ryanmio/EdmundFitzgeraldController/docs/images/forward-audio-component.jpeg

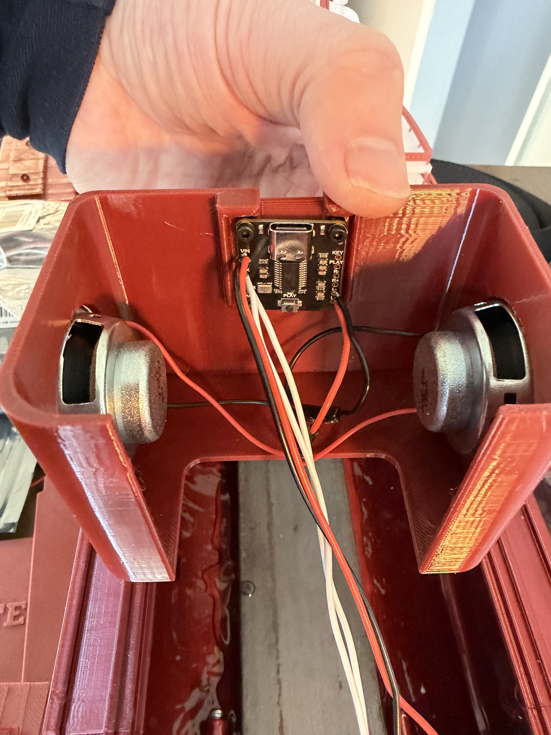
docs/images/forward-audio-component.jpeg
