ryanmio/EdmundFitzgeraldController/docs/UI_DESIGN_BRIEF.md

# UI Design Brief: 1970s Great Lakes Freighter Bridge Console

## Objective
Redesign the boat telemetry app UI to be **thematically authentic to a 1970s Great Lakes freighter bridge console**. The app should feel like you're controlling an actual Edmund Fitzgerald-era vessel.

## Visual Inspiration & Aesthetic

### Core Theme: Vintage Ship Bridge Console (circa 1970s)
- **Color Palette**: Deep teals, steel grays, muted oranges, black backgrounds with amber/green LED displays
- **Materials**: Brushed aluminum, steel, vintage gauge glass, weathered instrumentation
- **Lighting**: Low ambient lighting with bright instrument displays (like real bridge consoles)
- **Typography**: Industrial monospace fonts (like digital LED displays from that era)
- **Texture**: Slight grain/wear on surfaces, metal mesh backgrounds, subtle scanlines

### Reference Aesthetic
- 1970s maritime navigation equipment (radar scopes, depth finders, radio panels)
- Vintage control room instrumentation (physical buttons, rotary dials, analog gauges)
- Classic ship bridge layouts with clustered instrument banks
- Amber/green monochromatic displays (like old CRT monitors)
- Weathered but functional industrial design

---

## App Sections & Design Approach

### 1. **Connection Screen**
- Should feel like the "boot-up" screen of a 1970s naval computer
- Display: Amber monospace text on dark background
- Elements:
  - Ship silhouette or stylized Edmund Fitzgerald outline
  - IP address input styled like a vintage terminal/radio interface
  - Status lights (amber, red, green) for connection state
  - Connect button styled like a large industrial pushbutton
  - Easter egg: Startup sequence/boot animation

**Design Elements:**
- Flickering text effect (subtle, not annoying)
- Scandlines overlay (very light)
- Input field styled like a brass-trimmed control panel slot
- Status LEDs with glow effects

### 2. **Dashboard/Bridge Console (Main Screen)**
- Layout: Multi-panel bridge console feel
- Simulate a crew's-eye-view of instrumentation

#### Top Section: Header/Status Bar
- Ship name (USS Edmund Fitzgerald or similar styling)
- Current time (24-hour format, ship's time)
- Power button styled as vintage switch or emergency cutoff
- Signal strength displayed as classic dBm gauge or vertical bars (like old radio strength indicators)

#### Main Telemetry Panels (Arranged like real bridge stations)

**Panel 1: Power/Battery Station**
- Large analog gauge showing battery voltage (0-16V scale)
- Needle movement with subtle glow
- Readout text in amber monospace below
- Danger zone shading (red) at low voltages
- Background: Dark with grid pattern overlay

**Panel 2: Water Intrusion Detection**
- Large circular status display (like a depth gauge)
- "DRY" or "INTRUSION DETECTED" in bold amber text
- Alarm state: Red background with flashing border
- Subtle water wave animation when wet (optional)

**Panel 3: System Status/Uptime**
- Uptime in "HHMM:SS" format (ship chronometer style)
- Background: Black with subtle LED matrix pattern
- Font: Monospace, amber text
- Small annotations like "OPERATIONAL HOURS" above

**Panel 4: Signal Strength**
- Vertical bar graph (like old audio level meters)
- dBm reading in corner
- Color gradient: Green (good) → Yellow (fair) → Red (poor)
- Subtle needle animation

**Panel 5: LED Control Station**
- Two large toggle buttons styled like vintage control panel switches
  - "RUNNING MODE LED" - large industrial toggle
  - "FLOOD MODE LED" - large industrial toggle
- State indicators showing ON/OFF with glowing LED circles
- Styling: Brushed aluminum frame, recessed buttons, safety guards
- When active: Bright green LED glow, when off: dark gray
- Click/tactile feedback animation

#### Center/Lower Section: Optional Details
- System diagnostics readout (scrolling monospace text)
- Ambient shipboard sounds (very subtle - optional)
- "BRIDGE CONSOLE STATUS" panel with system health check

---

## Design Specifications

### Color Palette
```
Primary Colors:
- Background: #0a0e1a (Very dark blue-black)
- Text/Displays: #ffb000 (Amber/gold - classic LED color)
- Accent: #00c853 (Vintage green - active state)
- Alert: #ff3333 (Bright red - warning/alarm)
- Secondary: #4a5f7f (Steel gray for panels)

Gradients:
- Gauge backgrounds: Dark gray to black with slight metallic sheen
- Panel edges: Subtle beveled effect (raised or inset)
```

### Typography
- **Primary Font**: IBM Plex Mono, Courier Prime, or similar monospace
- **All text**: Uppercase or small-caps where appropriate (maritime style)
- **Sizes**: Large for critical info (battery, water status), smaller for labels

### Interactive Elements
- Buttons: Large, tactile, industrial pushbutton aesthetic
- Toggle switches: Classic up/down toggle style with physical appearance
- Gauges: Analog needle movement, glass reflection overlay
- Text displays: Dot-matrix or LED segment appearance

### Animation & Effects (Subtle, Authentic)
- Needle gauge movements: Smooth easing, slight overshoot (like real needles)
- Text flicker: Optional very subtle effect when connecting/updating
- LED glow: Bloom effect on active LEDs
- Scanlines: Ultra-light overlay (subtle, not distracting)
- Transitions: Fade or slide effects (avoiding 2020s smoothness)

---

## Layout Structure

### Spatial Arrangement (Bridge Console Pattern)
```
┌──────────────────────────────────────────────┐
│  [Ship Name]  [Time]  [Signal ▓▓▓▓░]  [⏻]   │  ← Header
├──────────────────────────────────────────────┤
│                                              │
│  [Battery Gauge]     [Water Status]         │  ← Row 1: Critical Systems
│   8.4V                 DRY                   │
│                                              │
├──────────────────────────────────────────────┤
│                                              │
│  [Uptime: 00:45:23]   [Signal: -53dBm]      │  ← Row 2: System Info
│                                              │
├────────────────────────────��─────────────────┤
│                                              │
│   ┌─ RUNNING MODE ─┐   ┌─ FLOOD MODE ─┐    │  ← Row 3: Control Switches
│   │  [LED: OFF]    │   │  [LED: OFF]   │    │
│   │  ◯ Toggle ON   │   │  ◯ Toggle ON  │    │
│   └────────────────┘   └───────────────┘    │
│                                              │
├──────────────────────────────────────────────┤
│ [DIAGNOSTIC STATUS]                         │
│ System Online | Console Active | GPS Sync   │  ← Footer (optional)
└──────────────────────────────────────────────┘
```

---

## Additional Features & Polish

### Accessibility & Usability
- High contrast for readability (amber on black meets WCAG standards)
- Large touch targets for buttons (for maritime/gloved hands)
- Simple iconography (if used)
- Status indicators always visible and unambiguous

### Optional Enhancements
- Subtle ambient shipboard sounds (low volume option)
- Small ship telemetry stats in corner ("CREW: 0 | CARGO: — | DRAFT: —")
- Fake "RADAR" or "SONAR" animations in background
- Ship log/event history panel (timestamp + event scrolling text)
- "MANUAL OVERRIDE" emergency button (styled for disconnect)

### Screen States

#### Normal Operation
- Steady amber glow, all systems reporting
- Calm, professional appearance

#### Alert State (Water Detected)
- Red background flash
- Alarm beep sound (optional)
- "⚠ WATER INTRUSION DETECTED" banner
- System continues operating but highlights danger

#### Disconnected State
- All displays dim/gray out
- Connection retry animation
- "SEARCHING FOR SIGNAL" text scrolling

---

## Design Deliverables

1. **Figma/Design File**: Full mockups of all screens and states
2. **Component Library**: Reusable UI components (gauge, button, panel, etc.)
3. **Color & Typography Guide**: Exact values for implementation
4. **Animation Specs**: Easing curves, timing for gauge movements, transitions
5. **Implementation Notes**: React Native code suggestions for achieving effects

---

## Tone & Philosophy

The UI should make the user feel like they're:
- Operating a real, historic Great Lakes freighter bridge
- Professional and capable, not just "using an app"
- Respectful of the ship's legacy and maritime heritage
- In control of something substantial and important

**Goal**: Every interaction should feel like stepping into a 1970s ship's bridge, even if just for a moment. The app is a tribute to the Edmund Fitzgerald and the era it represents.

---

## Next Steps for Designer

1. Start with the **Connection Screen** mockup (simplest)
2. Then design the **Dashboard/Main Console** layout
3. Create component variants (active/inactive states, alert states)
4. Build animation specs for gauges and LED indicators
5. Iterate with user feedback on authentic vs. modern balance
6. Finalize implementation strategy for React Native

---

**Brief prepared by**: Original Development Team  
**Date**: 2025-12-20  
**Target App**: Boat Telemetry - Edmund Fitzgerald Controller  
**Design Era**: 1970s Maritime Bridge Console Aesthetic
