ryanmio/EdmundFitzgeraldController/boat-telemetry-app/assets/boat.png

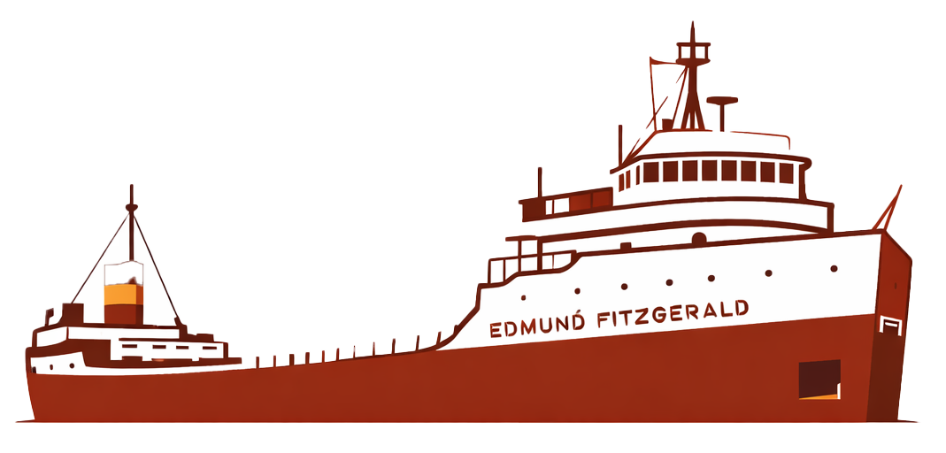
boat-telemetry-app/assets/boat.png
