ryanmio/EdmundFitzgeraldController/docs/images/cat-watching.jpeg

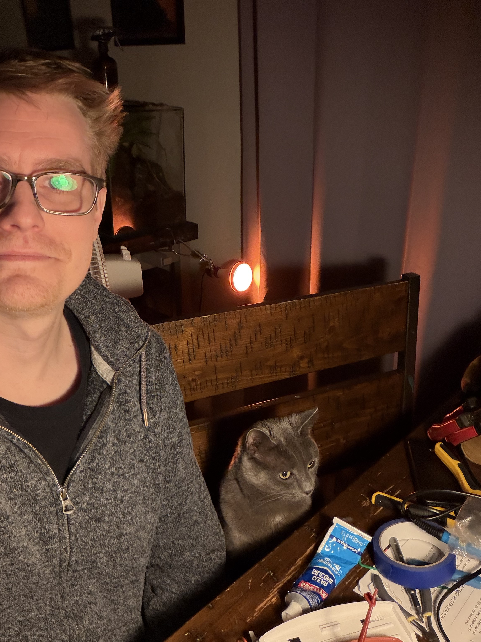
docs/images/cat-watching.jpeg
