ryanmio/EdmundFitzgeraldController/docs/images/interior-model.jpeg

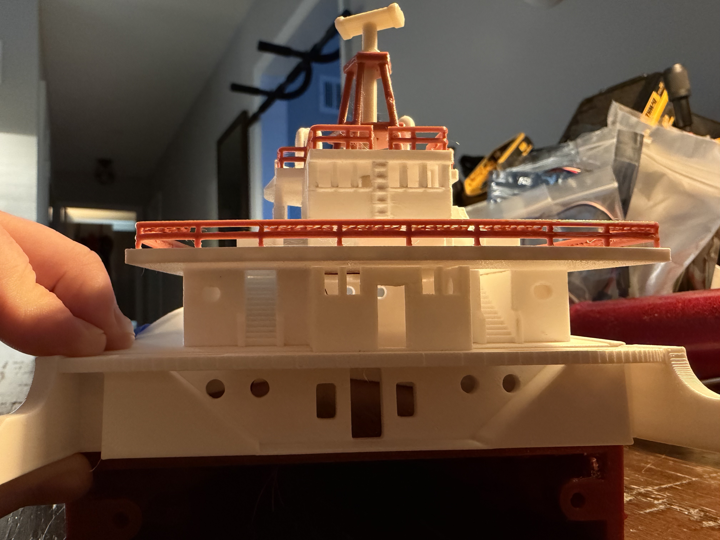
docs/images/interior-model.jpeg
