ryanmio/EdmundFitzgeraldController/docs/images/view-into-hull-from-above.jpeg

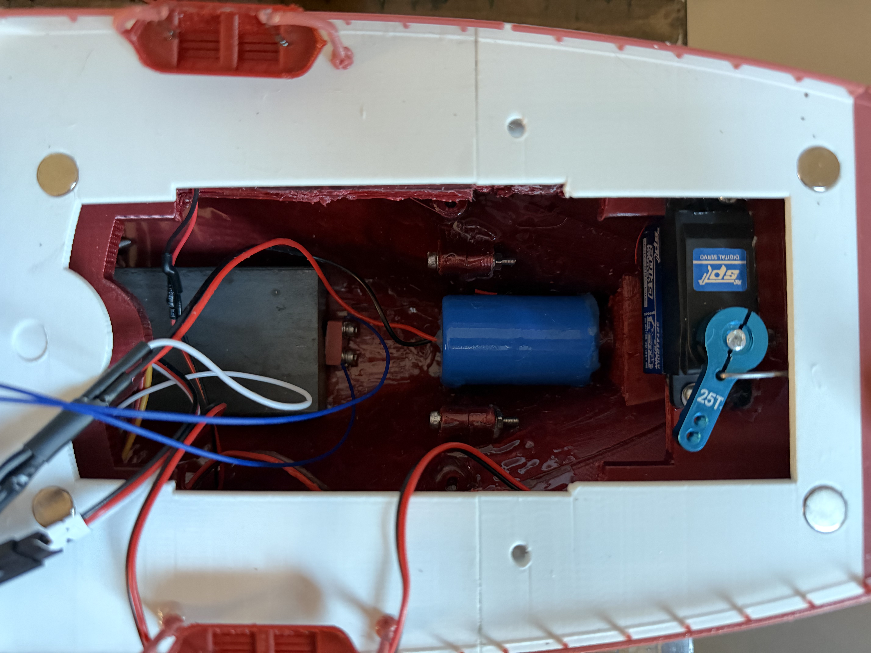
docs/images/view-into-hull-from-above.jpeg
