ryanmio/EdmundFitzgeraldController/docs/schematics/Edmund_Fitzgerald_Telemetry-backup.jpg

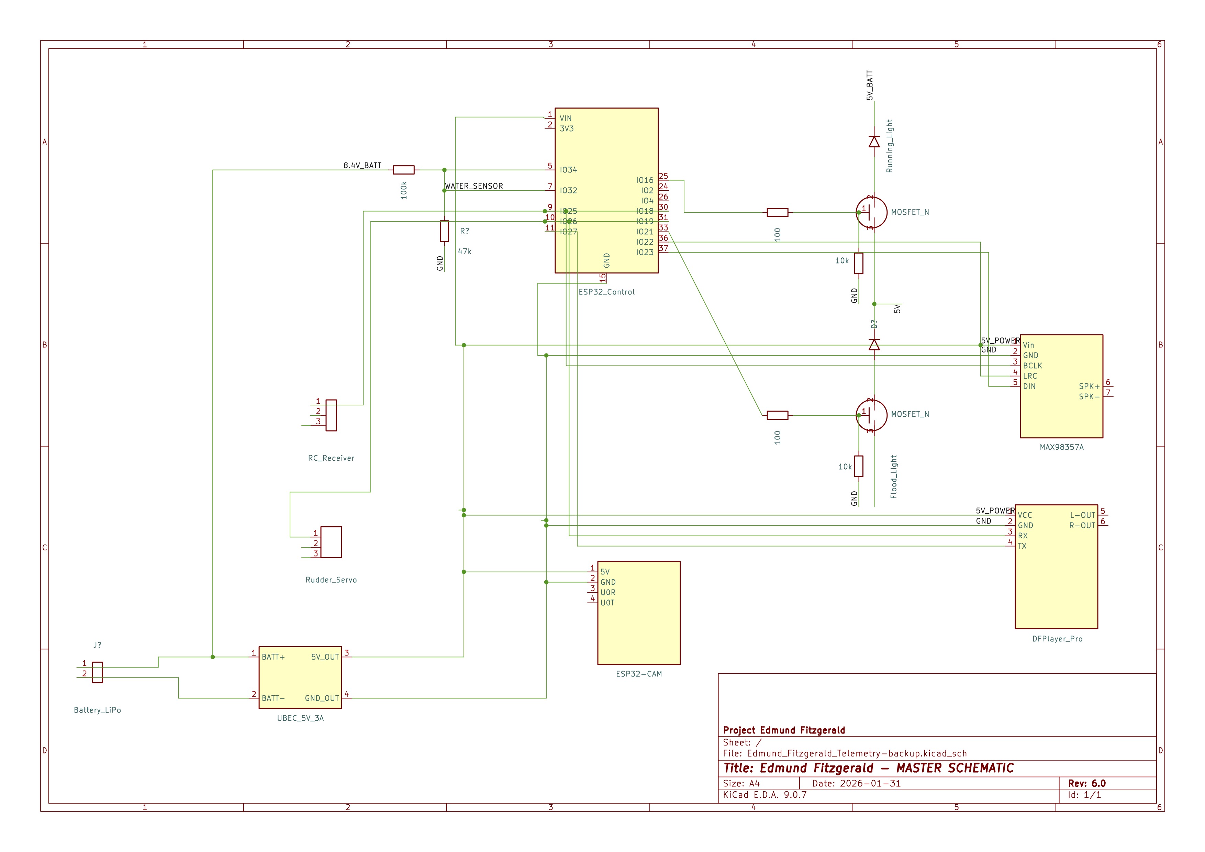
docs/schematics/Edmund_Fitzgerald_Telemetry-backup.jpg
