ryanmio/EdmundFitzgeraldController/docs/models/aft-audio-box.stl

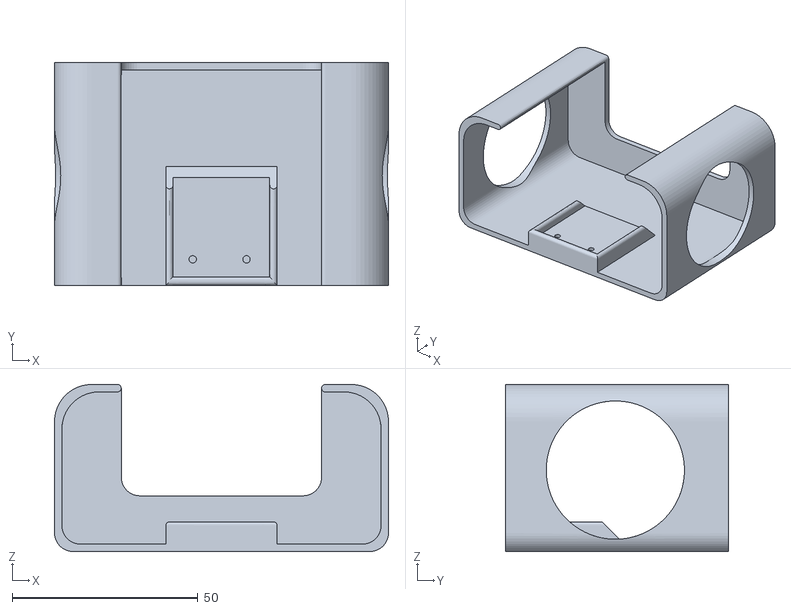
[picture p10: CAD file, 2026-02-01]
docs/models/aft-audio-box.stl
90.0 x 60.0 x 45.0
