ryanmio/EdmundFitzgeraldController/docs/models/esp32-housing.stl

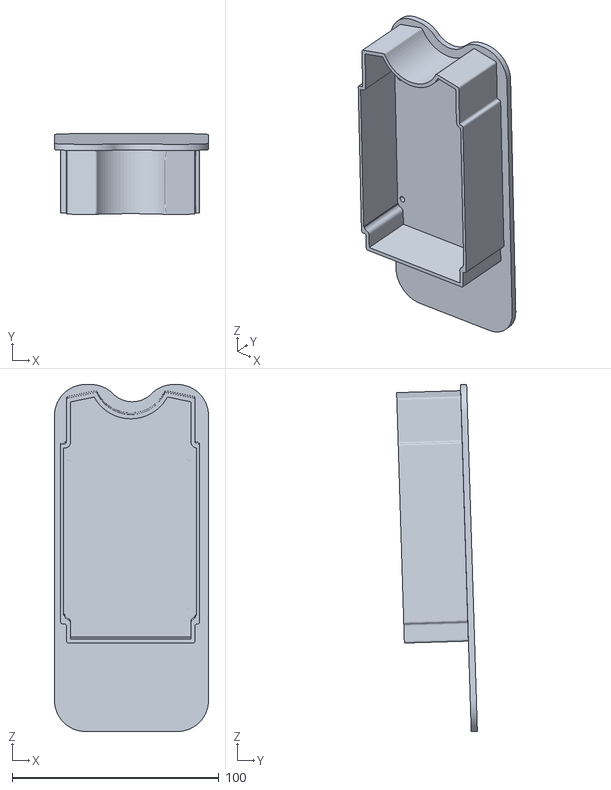
[picture p11: CAD file, 2026-02-01]
docs/models/esp32-housing.stl
74.5 x 39.1 x 167.8
