ryanmio/EdmundFitzgeraldController/docs/models/Plug Hatch.stl

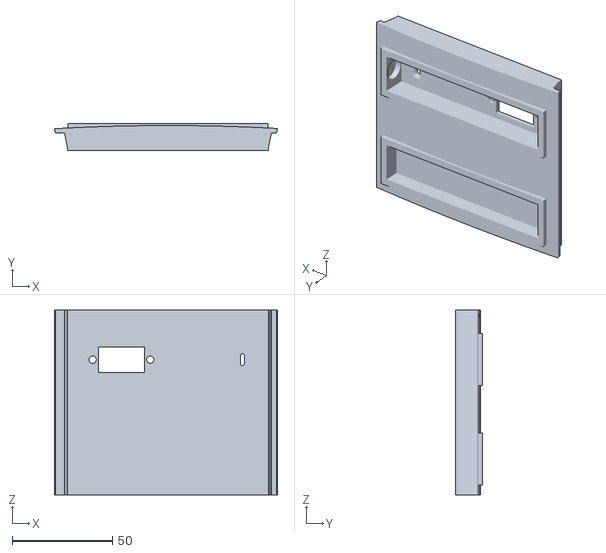
[picture p12: CAD file, 2026-02-01]
docs/models/Plug Hatch.stl
111.4 x 13.7 x 92.3
