ryanmio/EdmundFitzgeraldController/docs/models/Plug Hatch lid.stl

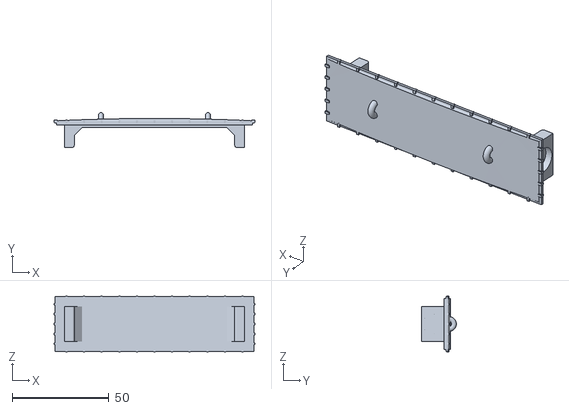
[picture p13: CAD file, 2026-02-01]
docs/models/Plug Hatch lid.stl
103.8 x 18.0 x 28.9
