ryanmio/EdmundFitzgeraldController/docs/models/forward-audio-box.stl

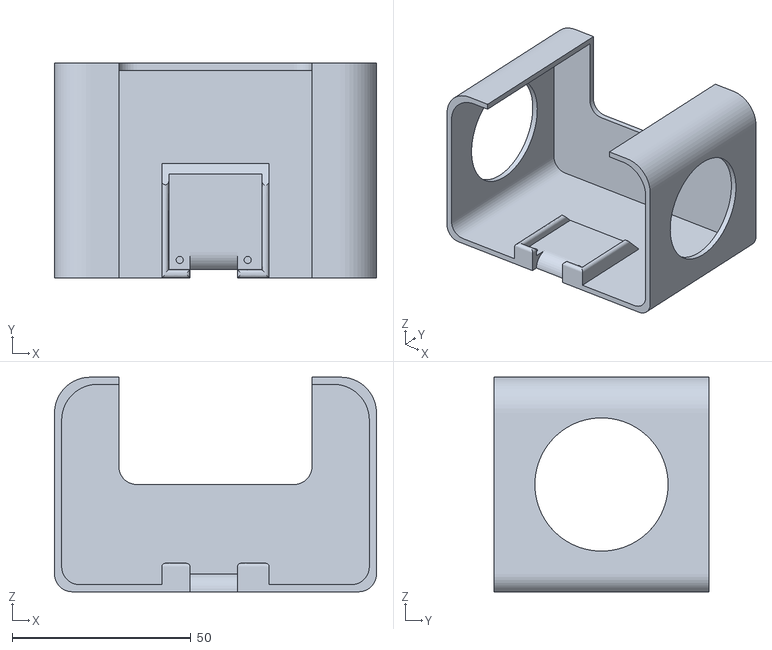
[picture p14: CAD file, 2026-02-01]
docs/models/forward-audio-box.stl
90.0 x 60.0 x 60.0
