ryanmio/EdmundFitzgeraldController/docs/models/computer lid v3.stl

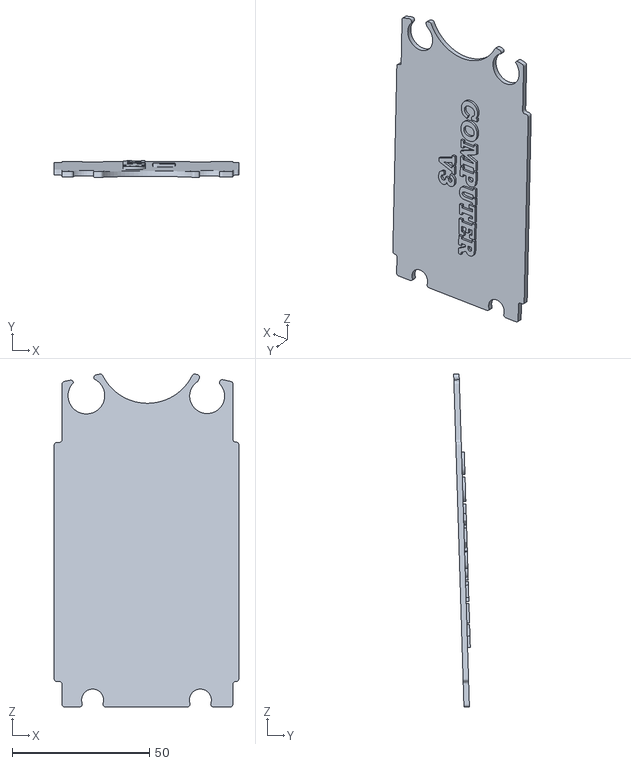
[picture p15: CAD file, 2026-02-01]
docs/models/computer lid v3.stl
67.2 x 6.08 x 121.2
