ryanmio/EdmundFitzgeraldController/docs/TESTFLIGHT_CHECKLIST.md

# TestFlight Deployment Checklist

## ✅ PRE-BUILD VERIFICATION (COMPLETED)

- [x] **TypeScript Compilation**: No type errors
- [x] **Dependencies**: All packages installed correctly
  - expo@54.0.30 ✓
  - react-native@0.81.5 ✓
  - react@19.1.0 ✓
  - All navigation and storage packages installed ✓
- [x] **Linter**: No linting errors in src/ directory
- [x] **App Configuration**: app.json properly configured
  - App Name: Edmund Fitzgerald ✓
  - Bundle ID: `com.ryanmio.edmundfitzgerald` ✓
  - Version: 1.0.0 ✓
  - Icon: 1024×1024 PNG, RGB format (no transparency) ✓
  - Splash screen assets present ✓
- [x] **Screen Components**: All three screens compile
  - ConnectionScreen.tsx ✓
  - DashboardScreen.tsx ✓
  - App navigation configured ✓
- [x] **Services**: All API services configured
  - esp32Service.ts (telemetry + LED control) ✓
  - storageService.ts (IP persistence) ✓
  - systemsCheckService.ts ✓
- [x] **Build Configuration**: eas.json ready for production build

---

## 🚀 BUILD & SUBMISSION STEPS

### Step 1: Verify Assets
Before building, verify all assets meet requirements:
```bash
cd boat-telemetry-app
node scripts/verify-assets.js
```

This checks:
- ✅ App icon is 1024×1024 PNG (RGB, no transparency)
- ✅ Splash screen is 1024×1024 PNG
- ✅ All required files exist

### Step 2: Verify Prerequisites
```bash
eas --version  # Should be >= 16.28.0
eas whoami     # Verify you're logged in
```

### Step 3: Build for iOS App Store
```bash
cd /Users/ryanmioduskiimac/Documents/GitHub/EdmundFitzgeraldController/boat-telemetry-app
eas build --platform ios --profile production
```

**Expected time**: 15-20 minutes
**Will**: Create a release build signed with your Apple certificates

### Step 4: Submit to TestFlight
```bash
eas submit --platform ios --latest
```

**Expected result**: Build automatically submitted to App Store Connect

### Step 5: Verify in App Store Connect
1. Go to https://appstoreconnect.apple.com
2. Select "Boat Telemetry" app
3. Navigate to TestFlight → iOS builds
4. Verify build is processing (should see "Processing" status)
5. Once ready, it will appear under "Builds Ready to Test"

### Step 5: Create Testing Group and Invite
1. In App Store Connect, go to TestFlight
2. Click "Internal Testing" or "External Testing"
3. Add testers' email addresses
4. Testers receive TestFlight invite
5. They download and test via TestFlight app

---

## 📋 IMPORTANT NOTES

- **Cost**: Each build uses 1 EAS build credit (you have a paid account)
- **Build is clean**: No errors, warnings, or dependency issues
- **Bundle ID is unique**: `com.ryanmio.edmundfitzgerald` (registered with Apple)
- **Version is tracked**: Set to 1.0.0, will auto-increment on next build if needed
- **All assets present**: Icon, splash screen, boat.png all verified

---

## ⚠️ WHAT TO DO IF BUILD FAILS

1. **Check Apple Developer Certificate**: Run `eas device` to verify credentials
2. **Check App Store Identifier**: Verify bundle ID matches App Store Connect
3. **Check EAS account**: Make sure you're logged in: `eas whoami`
4. **Review build logs**: EAS will provide detailed error output

---

## ✅ READY TO PROCEED?

All systems are GO for production build! Your app is:
- ✅ Fully type-safe (TypeScript compiles cleanly)
- ✅ All dependencies resolved
- ✅ No linting errors
- ✅ Properly configured for iOS
- ✅ Ready for TestFlight distribution

**COST: 1 EAS build credit**
