ryanmio/EdmundFitzgeraldController/docs/screenshots/screenshot-testflight-email.PNG

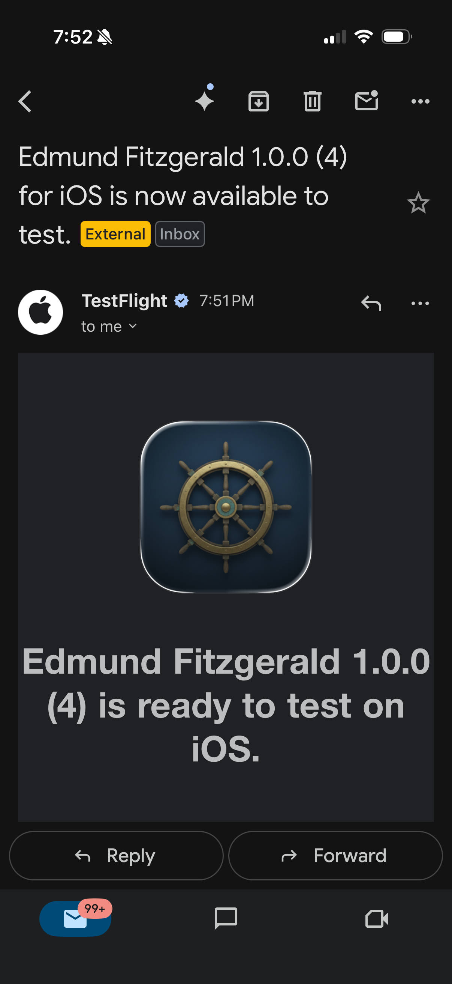
docs/screenshots/screenshot-testflight-email.PNG
