ryanmio/EdmundFitzgeraldController/firmware/boat_telemetry/audio_engine.cpp

// audio_engine.cpp
// Implementation of real-time engine audio sampler
// Uses FFT-filtered PCM data (offline processing) for click-free looping

#include "audio_engine.h"
#include "engine_pcm.h"  // FFT-filtered PCM data
#include <Arduino.h>

// Global engine state
EngineAudioState engineState;

// Linear interpolation helper (audioLerp to avoid std::lerp conflict)
static inline float audioLerp(float a, float b, float t) {
  return a + (b - a) * t;
}

// Soft clip using tanh - prevents harsh clipping artifacts
static inline float softClip(float x) {
  const float max_val = 32767.0f;
  const float k = 2.0f;
  float normalized = x / max_val;
  return (tanh(k * normalized) / tanh(k)) * max_val;
}

// Initialize audio engine
void audioEngine_init() {
  engineState.position = 0.0f;
  engineState.rate = 1.0f;
  engineState.gain = GAIN_MIN;
  engineState.smoothed_throttle = 0.0f;
  engineState.prev_throttle = 0.0f;
  engineState.rev_timer_ms = 0;
  engineState.last_update_ms = millis();
  engineState.startup_fade_remaining = (uint32_t)(44100 * START_FADE_MS / 1000);
  engineState.muted = false;
  
  Serial.println("Audio engine initialized (FFT-filtered loop)");
  Serial.printf("  PCM samples: %d (%.2fs @ %d Hz)\n", 
    ENGINE_PCM_LENGTH, 
    (float)ENGINE_PCM_LENGTH / ENGINE_PCM_SAMPLE_RATE,
    ENGINE_PCM_SAMPLE_RATE);
  Serial.printf("  Rate range: %.2f - %.2f\n", RATE_MIN, RATE_MAX);
  Serial.printf("  Gain range: %.2f - %.2f\n", GAIN_MIN, GAIN_MAX);
}

// Mute control functions
void audioEngine_setMuted(bool muted) {
  engineState.muted = muted;
  Serial.printf("Engine audio %s\n", muted ? "MUTED" : "UNMUTED");
}

bool audioEngine_getMuted() {
  return engineState.muted;
}

// Update throttle and recalculate rate/gain
void audioEngine_updateThrottle(float throttle_normalized) {
  // Clamp input
  if (throttle_normalized < 0.0f) throttle_normalized = 0.0f;
  if (throttle_normalized > 1.0f) throttle_normalized = 1.0f;
  
  // Calculate time delta for decay
  uint32_t current_ms = millis();
  uint32_t delta_ms = current_ms - engineState.last_update_ms;
  engineState.last_update_ms = current_ms;
  
  // Detect rev transient (rapid throttle increase)
  float throttle_delta = throttle_normalized - engineState.prev_throttle;
  if (throttle_delta > REV_THRESHOLD) {
    engineState.rev_timer_ms = REV_DECAY_MS + REV_RAMP_MS;
  }
  engineState.prev_throttle = throttle_normalized;
  
  // Decay rev timer
  if (engineState.rev_timer_ms > 0) {
    if (delta_ms >= engineState.rev_timer_ms) {
      engineState.rev_timer_ms = 0;
    } else {
      engineState.rev_timer_ms -= delta_ms;
    }
  }
  
  // Apply faster smoothing during rev transient for more responsive feel
  float smooth_alpha = THROTTLE_SMOOTH_ALPHA;
  if (engineState.rev_timer_ms > 0) {
    smooth_alpha = 0.35f;  // Much faster response during rev
  }
  
  // Exponential smoothing (boat-like inertia, faster during rev)
  engineState.smoothed_throttle = 
    engineState.smoothed_throttle * (1.0f - smooth_alpha) +
    throttle_normalized * smooth_alpha;
  
  // Calculate base rate and gain from smoothed throttle
  float base_rate = RATE_MIN + engineState.smoothed_throttle * (RATE_MAX - RATE_MIN);
  float base_gain = GAIN_MIN + engineState.smoothed_throttle * (GAIN_MAX - GAIN_MIN);
  
  // Apply rev boost if active (ramp-in then decay for realistic effect)
  if (engineState.rev_timer_ms > 0) {
    float total_time = REV_DECAY_MS + REV_RAMP_MS;
    float rev_elapsed = total_time - engineState.rev_timer_ms;
    
    float rev_amount = 0.0f;
    if (rev_elapsed < REV_RAMP_MS) {
      // Ramp-in phase: smoothly increase rev effect
      rev_amount = rev_elapsed / REV_RAMP_MS;
    } else {
      // Decay phase: gradually fade rev effect
      float decay_elapsed = rev_elapsed - REV_RAMP_MS;
      rev_amount = 1.0f - (decay_elapsed / REV_DECAY_MS);
    }
    
    base_rate *= 1.0f + (REV_BOOST_RATE - 1.0f) * rev_amount;
    base_gain *= 1.0f + (REV_BOOST_GAIN - 1.0f) * rev_amount;
  }
  
  // Update state
  engineState.rate = base_rate;
  engineState.gain = base_gain;
}

// Render PCM samples into buffer
void audioEngine_renderSamples(int16_t* buffer, size_t count) {
  // If muted, output silence
  if (engineState.muted) {
    for (size_t i = 0; i < count; i++) {
      buffer[i] = 0;
    }
    return;
  }
  
  for (size_t i = 0; i < count; i++) {
    // Get integer and fractional parts of position
    uint32_t idx = (uint32_t)engineState.position;
    float frac = engineState.position - (float)idx;
    
    // Simple wrap (FFT filtering ensures periodic continuity)
    if (idx >= ENGINE_PCM_LENGTH) {
      engineState.position = frac;
      idx = 0;
    }
    
    // Get current and next samples for interpolation
    int16_t sample0 = ENGINE_PCM_DATA[idx];
    int16_t sample1 = ENGINE_PCM_DATA[(idx + 1) % ENGINE_PCM_LENGTH];
    
    // Linear interpolation for smooth pitch shifting
    float interpolated = audioLerp((float)sample0, (float)sample1, frac);
    
    // Apply gain
    interpolated *= engineState.gain;
    
    // Startup fade-in to prevent initial pop
    if (engineState.startup_fade_remaining > 0) {
      float progress = 1.0f - ((float)engineState.startup_fade_remaining / (44100 * START_FADE_MS / 1000));
      interpolated *= progress;
      engineState.startup_fade_remaining--;
    }
    
    // Soft clip to prevent harsh distortion
    buffer[i] = (int16_t)softClip(interpolated);
    
    // Advance position by playback rate
    engineState.position += engineState.rate;
  }
}
