ryanmio/EdmundFitzgeraldController/(commit log)

2025-12-17 docs: Initial project prompt with Phase 1-5 system instructions - clarified WiFi approach, sensor scoping, and development phases
2025-12-18 Phase 2 WIP: WiFi auto-connect working - ESP32 connects to iPhone hotspot and hosts HTTP server on 172.20.10.4:80
2025-12-18 Phase 2: All HTTP endpoints working - /status, /telemetry, /led functional. WiFi scans and matches iPhone hotspot by name. Tested curl from Mac on same hotspot.
2025-12-18 Phase 2 & 3 Complete: Dual-network ESP32 firmware + Working Expo web app
    - Updated firmware to prioritize home WiFi (.hidden) with fallback to iPhone hotspot
    - Added CORS headers to all endpoints for web app compatibility
    - Created Expo boat-telemetry-app with 3 screens (Connection, Telemetry, LED Control)
    - App successfully connects to ESP32 on home WiFi (192.168.1.178)
    - 1-second telemetry polling working
    - LED control (running/flood) responding correctly
    - Web app tested and running on http://localhost:8081
    - Ready for extended testing and field deployment
    [boat_telemetry.ino]
2025-12-18 Update project documentation: rename prompt.md to plan.md with Phase 2-3 completion status
    - Documented all completed phases
    - Updated current status and test results
    - Listed working IP and configuration
    - Created deployment checklist
    - Added next session todo items
    - Ready for Phase 4 testing
2025-12-19 UI Redesign: Unified dashboard with inline LED control, water sensor, and camera placeholder
    - Consolidated 3 screens into single Dashboard with all controls
    - LED toggles now tap-able cards on main screen (no separate navigation)
    - Added disconnect confirmation dialog
    - Implemented water intrusion sensor (GPIO 35, ADC input)
    - Added camera feed placeholder (16:9 aspect ratio, ready for ESP32-CAM)
    - Updated firmware to include water sensor in telemetry response
    - Signal strength now shows visual bar indicators
    - Improved visual hierarchy with sections and icons
    - Better error handling and state management
    - Deleted old TelemetryScreen and LEDControlScreen
    [boat_telemetry.ino]
2025-12-19 Add persistent data logging with CSV export
    - Implemented in-memory telemetry logging (every 1 second while connected)
    - Log data persists to AsyncStorage (survives app restart)
    - Log state (recording/stopped, start time) remembered between sessions
    - CSV export includes all telemetry fields with timestamps
    - Web: download CSV file directly
    - Mobile: export via Share sheet (Files, Email, Messages, etc)
    - Fixed disconnect confirmation to work on web (window.confirm)
    - Added logging UI controls: Record/Stop, Export, Clear
    - Live logging statistics: entry count and duration timer
    - Debounced saves every 2 seconds to minimize storage writes
    - Ready for TestFlight deployment with full data persis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
2025-12-19 Camera integration complete: ESP32-CAM MJPEG streaming in app
    - Added camera_stream firmware for ESP32-CAM with /stream MJPEG endpoint
    - CORS headers enable browser/app MJPEG display
    - App now displays live camera feed via simple <img> tag polling
    - Added Camera IP field to connection screen (optional, persisted)
    - Dashboard shows live MJPEG stream overlay with LIVE indicator
    - Supports both web and mobile (Expo) platforms
    - Stream URL: http://<camera-ip>/stream
    - Telemetry and camera on separate boards (Option B architecture)
    - Working without major memory/stability issues at QVGA quality
    [camera_pins.h, camera_stream.ino]
2025-12-20 Fix water intrusion sensor pin: GPIO32 has internal pullup, GPIO35/34/36/39 do not
    - Changed WATER_SENSOR_PIN from 33 to 32
    - GPIO32 has internal pull-up resistor (required for INPUT_PULLUP mode)
    - GPIO34/35/36/39 are input-only pins without internal pull-up (float to LOW = always WET)
    - Tested and confirmed working: GPIO32 to GND triggers WET, release triggers DRY
    - Board orientation verified through pin testing
    [boat_telemetry.ino]
2025-12-20 Battery voltage ADC calibration: multiplier 2.84 for 100k+47k divider
    - Calibrated against 3.3V test: reading now accurate
    - 8.4V LiPo reads correctly
    - Firmware calculates: batteryVoltage = adcPin * 3.3 * 2.84
    - GPIO34 wired to voltage divider junction
    - Battery GND connected to ESP32 GND (complete circuit)
    - Both sensors now operational (water intrusion + battery)
    [boat_telemetry.ino]
2025-12-20 Add external LED control pins for MOSFET drivers
    - GPIO16: Running lights (MOSFET CH1 gate) - external LED group
    - GPIO17: Flood lights (MOSFET CH2 gate) - external LED group
    - GPIO2: Onboard LED (kept for visual testing feedback)
    - GPIO4: Legacy flood output (optional spare)
    - Ready for MOSFET module wiring when hardware arrives
    - 18 micro LEDs planned: 6 Running + 6 Flood + 6 spare
    - Each LED needs 150Ω series resistor + common ground to MOSFET/ESP32
2025-12-20 feat: redesign UI with 1970s Great Lakes freighter bridge console aesthetic
    - Create Theme.ts with vintage color palette (amber text, dark backgrounds, steel gray panels)
    - Redesign ConnectionScreen as 1970s naval computer boot-up interface
    - Add ship silhouette logo
    - Styled inputs as control panel slots with decorative labels
    - Terminal-style status messages
    - Industrial pushbutton design
    - Redesign DashboardScreen as multi-panel bridge console
    - Add ship chronometer and current time display
    - Power Station panel with analog gauge (0-16V battery voltage)
    - Hull Integrity panel with water intrusion status and glow effects
    - Signal Relay panel with dBm reading and visual bars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
2025-12-21 Add RC receiver PWM telemetry (throttle & servo) and power integration notes
    - Add PWM reading for throttle (GPIO18) and servo (GPIO19) channels
    - Include throttle_pwm and servo_pwm in telemetry JSON response
    - Add power integration note: both ESP32 boards powered from same BEC with shared ground
2025-12-21 Add hardware integration guide with step-by-step wiring instructions
    - Complete integration checklist for all components
    - One-sentence steps for power, sensors, RC receiver, LEDs, and camera
    - Pin summary table and verification checklist
2025-12-24 Add pre-flight diagnostic system with connection stability check
    - Add free_heap to ESP32 firmware telemetry
    - Update TypeScript types for new telemetry fields (free_heap, throttle_pwm, servo_pwm)
    - Add DIAG button (◈) to dashboard header
    - Implement PreFlightModal with industrial console styling
    - Add connection stability test (3 rapid requests, measures avg/max latency)
    - Clean implementation: no re-render issues, runs once on manual trigger
    - Logs to both UI and browser console for debugging
    [boat_telemetry.ino]
2025-12-24 Complete pre-flight diagnostic system with all 8 checks
    - Add all 8 diagnostic checks: connection, hull, power, RF, RC link, processor, LEDs, camera
    - Auto-start telemetry recording if all checks pass
    - Track pass/fail count and show final mission status
    - Non-critical camera check won't abort mission
    - LED functional test cycles both running and flood lights
2025-12-25 Fix camera validation - use GET instead of HEAD for streaming endpoints
    - Change from HEAD to GET request (HEAD doesn't work well with MJPEG streams)
    - Reduce timeout from 30s to 5s (still plenty of time)
    - Accept HTTP 200 or 206 responses (206 is partial content for streams)
    - Camera check remains non-critical - won't fail mission
2025-12-25 Fix camera validation - ping host instead of fetching stream
    - Changed from fetching stream to pinging camera host
    - Avoids timeout issues with MJPEG streams that hang on fetch
    - Uses HEAD request with no-cors mode to just test connectivity
    - 3 second timeout for quick validation
    - Still non-critical - won't fail mission
2025-12-25 Simplify camera check - manual visual verification
    MJPEG streams cannot be reliably validated programmatically:
    - Streams are infinite and never fire onload events
    - fetch() hangs or is blocked by CORS
    - Image probes timeout on continuous streams
    Solution: Mark as passed if configured, prompt user to verify visually.
    Camera feed already displays live in dashboard - that's the real test.
2025-12-25 Remove camera validation check - MJPEG streams cannot be reliably tested
    Camera feed displays live in dashboard - visual verification is sufficient.
    Reduced to 7 mission-critical checks.
2025-12-25 capacitor details
2025-12-27 feat: Add network device discovery with automatic ESP32 scanning
    - Implement NetworkScanService to discover ESP32 devices on local network
    - Scan 192.168.1.x and 192.168.0.x subnets (IPs 100-200 range)
    - Add DeviceScannerModal component for user-friendly device selection
    - Integrate scan buttons into ConnectionScreen for both telemetry and camera ESP32s
    - Auto-detect device type (telemetry vs camera) based on /status response
    - Show real-time scan progress with device count and IP count
    - Add comprehensive logging for debugging network issues
    - Maintain manual IP input as fallback option
    - No firmware changes required - uses existing /status endpoints
    - Documentation: DEVICE_DISCOVERY.md, DE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
2025-12-28 Fix voltage check threshold to accept 8.1-8.8V range
    Changed from < 11.5V (incorrect for 8.4V nominal system) to check if voltage is outside 8.1-8.8V range. 8.59V is now correctly flagged as nominal.
2025-12-28 Fix camera stream display on mobile iOS using WebView
    React Native's Image component doesn't properly support MJPEG streams on iOS.
    Switched to WebView with HTML wrapper for mobile platforms while keeping
    native img tag for web. Stream works on both platforms now.
2025-12-28 Add camera init retry logic with auto-reboot
    ESP32-CAM can fail to initialize camera on first boot. Added 3 retry
    attempts with 1s delays. If all fail, automatically reboot to recover.
    This fixes the issue where Arduino serial connection was needed to reset.
    [camera_stream.ino]
2025-12-28 Add camera frame capture verification on boot
    Test actual frame capture after camera init to catch cases where
    init reports success but camera isn't working. Forces reboot if
    test frame capture fails. Should fix issue where stream stays black
    until hardware reset via Arduino IDE serial connection.
    [camera_stream.ino]
2025-12-29 Add 10-second debouncing to water intrusion sensor
    - Prevents false alarms from water sloshing/waves
    - Water must be detected continuously for 10 seconds to register as 'breached'
    - Hull must be dry for 10 seconds to register as 'secure'
    - Minimal CPU/memory overhead (~1 microsecond per loop, 12 bytes RAM)
    - Still provides raw sensor value in telemetry for debugging
    - One-time implementation, no ongoing testing needed
    [boat_telemetry.ino]
2025-12-29 Improve connection lost banner positioning for iOS notch safety
    - Wrap banner in SafeAreaView to automatically account for notch, dynamic island, and other safe areas
    - Add bottom border to banner for better visual distinction
    - Increase vertical padding for better appearance
    The banner now positions correctly below the notch on iPhone X+ and adapts to safe areas on all devices.
2025-12-30 Move camera WiFi credentials to secrets.h for consistency and security
    - Created secrets.h.example template for camera firmware
    - Move HOME_WIFI_SSID, HOME_WIFI_PASSWORD, and HOTSPOT credentials to secrets.h
    - Update camera_stream.ino to include secrets.h instead of hardcoding credentials
    - Improve hotspot matching: use exact SSID match instead of generic "iPhone" search
    - Credentials now consistent between telemetry and camera boards and protected from accidental commits
2025-12-31 Add Morse code SOS distress signal to flood detection mode
    Replaces LED-based flood indicator with PWM-controlled piezo buzzer that plays authentic WW2-era telegraph tones. When flood mode is enabled, the system continuously broadcasts SOS in 800Hz Morse code (... --- ...) with 2-second pauses between repeats.
    Key features:
    - Classic 800Hz telegraph tone (not harsh buzzer)
    - Proper Morse code timing (dits, dahs, gaps)
    - Uses existing MOSFET output on GPIO17
    - Supports parallel buzzers for increased volume
    - Automatically stops tone when flood mode disabled
    [boat_telemetry.ino]
2025-12-31 Add processor temperature monitoring to preflight systems check
    - Add internal temperature sensor reading to telemetry endpoint
    - Implement thermal health check with three-tier alerting (nominal/warning/critical)
    - Update systems check from 7 to 8 checks with proper numbering
    - Detects electrical faults indirectly via thermal signatures
2025-12-31 Allow mobile WebView camera stream over HTTP.
    Adds ATS/local-network allowances for iOS, enables Android cleartext traffic, and surfaces WebView stream load errors so black screens are diagnosable.
2026-01-01 Add video recording feature to camera feed.
    - Record button on camera overlay captures frames from /still endpoint
    - Saves frames as photos in Expo Go (limited to 30 frames)
    - Full MP4 encoding available in development builds via FFmpeg
    - Uses expo-file-system and expo-media-library for storage
2026-01-02 Fix Morse code buzzer for ESP32 library 3.3.4 compatibility
    Update ledcSetup/ledcAttachPin to newer ledcAttach API and use pin-based tone control instead of channel numbers. Resolves compilation errors with ESP32 3.3.4 library.
    [boat_telemetry.ino]
2026-01-03 Revert "Add video recording feature to camera feed."
    This reverts commit 9086127a145c36b5b464c16ceafd8dbd9e657c0e.
2026-01-06 Add startup visual feedback sequence to boat telemetry
    - Single 1-second flash on boot complete
    - Two quick flashes when WiFi connects successfully
    - Uses running lights (onboard LED + external MOSFET output)
    - Simple non-intrusive indication for power-on status
2026-01-06 Fix blocking issue in Morse code SOS playback
    Replace blocking delay-based Morse code playback with non-blocking state machine. This allows HTTP requests (app toggles) to be processed immediately while SOS plays in the background. Resolves issue where flood mode toggle would hang after first activation.
    [boat_telemetry.ino]
2026-01-07 Split flood MOSFET power control from Morse buzzer I/O
    Keep GPIO17 as the flood MOSFET gate so the flood circuit can power LEDs/loads later, and move the buzzer PWM signal to GPIO25 (buzzer module I/O pin). Prevents PWM from modulating the MOSFET gate/power rail while preserving the existing two-wire flood power feed into the hull.
    Wiring:
    - Flood MOSFET OUT+/OUT- -> buzzer VCC/GND
    - ESP32 GPIO25 -> buzzer I/O
    - ESP32 GPIO17 -> flood MOSFET TRIG/PWM (gate)
    [boat_telemetry.ino]
2026-01-07 Add Morse code success tones to boot and WiFi connection
    Adds audio feedback during startup sequence:
    - Boot complete: dit-dit-dit (... - three short beeps)
    - WiFi connected: dit-dah-dit (.-. - acknowledged pattern)
    Both tones play synchronously with LED flash sequences to confirm system status.
    [boat_telemetry.ino]
2026-01-07 Change Morse buzzer I/O pin from GPIO25 to GPIO22
    [boat_telemetry.ino]
2026-01-08 Fix buzzer backfeed issue - power MOSFET before playing tones
    The buzzer was receiving PWM signals while unpowered, causing current
    to backfeed through the module and overdraw GPIO22, potentially
    damaging the ESP32. Now the flood MOSFET (GPIO17) turns on first
    to power the buzzer before any tones play, then turns off after.
    [boat_telemetry.ino]
2026-01-08 Simplify buzzer wiring - remove MOSFET, use direct GPIO17
    Major safety improvements after catastrophic wiring failure:
    Firmware changes:
    - Buzzer now gets constant 5V power (no MOSFET switching)
    - GPIO17 drives buzzer I/O directly for tones
    - Removed GPIO22 usage entirely
    - Removed all FLOOD_OUT_PIN MOSFET control code
    - Only one MOSFET remains (GPIO16 for running lights)
    Integration guide updates:
    - Added safety section with critical rules
    - Added pre-power multimeter test requirement
    - Added incremental testing procedure (one circuit at a time)
    - Simplified buzzer wiring (3 wires: VCC to 5V, GND to GND, I/O to GPIO17)
    - Added troubleshooting section for common failures
    - Updated pin summ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
    [boat_telemetry.ino]
2026-01-10 Add build ID and firmware version to telemetry and camera endpoints
2026-01-11 Prepare firmware for PAM8403 speaker amplifier audio output
    Changes for v1.1.0:
    - Renamed MORSE_BUZZER_PIN to AUDIO_OUT_PIN (GPIO17)
    - Updated comments to reflect PAM8403 + speaker setup
    - Added HORN_FREQUENCY definition (200Hz for future boat horn)
    - Added playBoatHorn() function (future feature)
    - Compatible with both speaker amp and piezo buzzer modules
    - Incremented build ID to 20260110
    Hardware: GPIO17 → PAM8403 INL → Speaker (or piezo buzzer I/O)
    This provides much louder audio output than direct piezo connection.
    [boat_telemetry.ino]
2026-01-11 Update integration guide for PAM8403 speaker amplifier
    Replace piezo buzzer instructions with PAM8403 + speaker setup:
    - PAM8403 amplifier wiring (VCC, GND, INL to GPIO17)
    - Speaker connection (4Ω/8Ω, 40-50mm recommended)
    - Updated pin summary (Audio Output on GPIO17)
    - Updated testing procedure for speaker setup
    - Note: Still compatible with piezo buzzer modules
    This provides much louder audio output for Morse code SOS
    and future boat horn sound effects.
2026-01-11 Replace flood toggle with momentary horn and SOS buttons
    Firmware v1.2.0 changes:
    - Removed flood mode toggle (ledFloodState)
    - Added horn sound effect (2 sec blast per trigger)
    - Added SOS sound effect (3 rounds per trigger, ~18 sec total)
    - New endpoints: POST /horn and POST /sos
    - Updated /status and /telemetry to include horn_active and sos_active
    - Removed flood_led from all responses
    - Horn: 200Hz tone for 2 seconds
    - SOS: 800Hz Morse code, plays 3 complete rounds then stops
    - Both are non-blocking and stop automatically after fixed duration
    - Safe design: no "stuck on" if connectivity drops
    API changes:
    - POST /horn → triggers one 2-second horn blast
    - POST /sos → triggers 3 roun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
    [boat_telemetry.ino]
2026-01-11 Replace flood toggle with momentary horn and SOS buttons in app
    App changes:
    - Replaced flood light toggle with Horn and SOS momentary buttons
    - Horn button: press = 2 sec blast, hold = repeated blasts every 2.5s
    - SOS button: press = 3 rounds (~18s), hold = repeated triggers every 19s
    - Added triggerHorn() and triggerSOS() to esp32Service
    - Updated types: removed flood_led/flood_mode_state, added horn_active/sos_active
    - Updated CSV export headers to include horn_active and sos_active
    - Updated UI: Audio System panel with two large buttons
    - Added visual indicators (dots) showing when horn/SOS are active
    - Hold-to-repeat functionality with automatic cleanup on unmount
    Safe design: buttons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
2026-01-11 Add audio-assets folder structure for DFPlayer module
    - Created audio-assets/ directory for organizing sound effect MP3s
    - Added README.md with track mapping table and upload instructions
    - MP3s stored in repo for reference, copied to DFPlayer as numbered tracks
    - Documentation for firmware and app integration workflow
2026-01-11 Redesign controls layout: combine lighting and horn into Controls panel
    UI Changes:
    - Merged External Lighting and Audio System into single 'Controls' panel
    - Running Lights: toggle switch (unchanged)
    - Flood: toggle switch (placeholder for future feature)
    - Horn: Large circular button with orange border, boat-style design
    - Added new 'Radio Transmissions' panel below Controls
    - Radio panel includes: SOS + Radio 1/2/3 placeholder buttons
    - Grid layout for radio buttons (2x2)
    - SOS button styled with red border
    - All buttons have active indicators
    Design:
    - Horn button: circular, orange glow, pressed state animation
    - Radio buttons: compact grid, consistent spacing
    - Placeholder buttons for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
2026-01-11 Clean up controls: remove LED indicators from horn and radio buttons, shrink horn
    Changes:
    - Removed LED status indicators from horn button
    - Removed LED indicators from all radio transmission buttons
    - Horn button: reduced width from 80% to 60%
    - Horn button: reduced padding from 24 to 18
    - Horn text: reduced font size from 20 to 18
    - Cleaned up unused indicator styles
    Horn and radio buttons now cleaner without unnecessary status dots
2026-01-11 Improve button click effects: remove SOS special styling, add clicky press states
    - SOS button now matches other radio buttons (removed red border/dark background)
    - Radio buttons: click effect now scales down and darkens background (more realistic)
    - Horn button: improved press effect with scale and darker background
    - Replaced opacity fades with transform scale + color changes for tactile feel
    Press states now feel more like physical buttons being pushed
    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
2026-01-11 Simplify button press effect: scale only, no color changes
    - Radio buttons: only scale down (0.92) on press, no background/border color change
    - Horn button: only scale down (0.93) on press, no color changes
    - More realistic ship console button feel - like physical buttons being depressed
    Buttons now look like real mechanical switches instead of digital effects
    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
2026-01-11 Improve button animations with smooth Animated API
    - Replace state-based button scaling with React Native Animated.spring for smooth, professional animations
    - Add activeOpacity={1} to all buttons to disable default TouchableOpacity darkening
    - Implement snappy spring animations (tension: 100, friction: 10)
    - Set subtle scale values: Horn button (0.95), Radio/SOS buttons (0.97)
    - Remove transparent modal overlay (no background darkening)
    - Fix Radio button labels (Radio 2, Radio 3)
    - Clean up unused style properties (hornButtonPressed, radioButtonActive)
    Result: Clean, smooth, iOS-like button press feedback without choppy transitions or unwanted darkening effects.
2026-01-11 Implement radio sound effect endpoints with proper debouncing
    Frontend Changes:
    - Add RadioResponse type for /radio endpoint responses
    - Implement triggerRadio() service function with radio_id parameter
    - Add radio button handlers with debouncing (triggers once, repeats every 3s if held)
    - Add state tracking for each radio button (triggeringRadio1/2/3)
    - Add interval refs for long-press detection (radio1/2/3IntervalRef)
    - Replace Alert placeholders with actual API calls
    Firmware Changes:
    - Add radio sound effect state variables (radioActive, radioStartTime, currentRadioId)
    - Implement handleRadio() endpoint handler with JSON parsing for radio_id (1-3)
    - Add updateRadio() function for non-bl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
    [boat_telemetry.ino]
2026-01-11 Restore flood light toggle functionality
    Firmware v1.3.0 changes:
    - Add FLOOD_OUT_PIN (GPIO21) for MOSFET gate control
    - Re-add LED_FLOOD_PIN (GPIO4) for indicator LED
    - Add ledFloodState global variable
    - Update /led endpoint to handle flood mode (same as running mode)
    - Add flood_led to /status response
    - Add flood_mode_state to /telemetry response
    - Initialize flood pins in setup() (both OUTPUT, start LOW)
    Frontend changes:
    - Add togglingFlood state variable
    - Implement toggleFloodLED() function (mirrors toggleRunningLED)
    - Update flood button to call toggleFloodLED instead of showing alert
    - Display flood state from telemetry.flood_mode_state
    - Update LED indicator to show flood state (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
2026-01-11 Add permanent firmware-level audio volume control
    Volume levels (PWM duty cycle 0-255):
    - Horn: 255 (100%) - LOUD - full alarm volume
    - SOS: 200 (~78%) - LOUD - distress signal needs to be heard
    - Radio: 120 (~47%) - MODERATE - quieter background transmissions
    - Add HORN_VOLUME, SOS_VOLUME, RADIO_VOLUME constants
    - Replace ledcWriteTone() with ledcSetup/ledcAttach/ledcWrite pattern
    - ledcWrite() controls PWM duty cycle (0-255) for volume
    - Horn handler: Sets up PWM, writes HORN_VOLUME
    - SOS handler: Sets up PWM, writes SOS_VOLUME, maintained during pattern
    - Radio handler: Sets up PWM, writes RADIO_VOLUME
    - updateHorn/updateSOS/updateRadio: Use ledcWrite(0) for silence
    Benefits:
    -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
    [boat_telemetry.ino]
2026-01-11 Update integration guide with flood lights and audio volume levels
    Documentation updates:
    - Add new FLOOD LIGHTS section with GPIO21 MOSFET wiring
    - Add GPIO4 optional indicator LED for flood mode feedback
    - Update audio section with permanent volume levels:
    * Horn: 255/255 (100%) - Loud
    * SOS: 200/255 (~78%) - Loud distress
    * Radio: 120/255 (~47%) - Moderate
    - Add Phase 5 testing procedure for flood lights MOSFET
    - Rename Phase 5 to Phase 6 for audio, Phase 6 to Phase 7 for RC, Phase 7 to Phase 8 for camera
    - Update verification checklist with flood lights and audio testing
    - Update PIN SUMMARY table to include GPIO4 (flood indicator) and GPIO21 (flood MOSFET)
    - Clarify horn is loudes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
2026-01-11 Add DFPlayer Mini audio support (v2.0.0)
    - Firmware v2.0.0: DFPlayer integration with onboard 128MB storage
    - DFPlayer on GPIO25/26 (serial communication)
    - Track mapping: 001-003.mp3 for Edmund Fitzgerald radio transmissions
    - Updated integration guide with DFPlayer wiring instructions
    - Added recording guide for historical radio transmissions
2026-01-11 Add Edmund Fitzgerald radio transmission MP3s
    - 001.mp3: Fence rail down (3:30 PM damage report)
    - 002.mp3: Lost both radars (5:20 PM systems failure)
    - 003.mp3: We are holding our own (7:10 PM final transmission)
    - Chronological order for historical accuracy
    - Ready to upload to DFPlayer Mini onboard storage
2026-01-11 Fix track mapping to chronological order
2026-01-11 Update radio transmission labels with actual Edmund Fitzgerald quotes
    - Radio 1: FENCE RAIL DOWN (3:30 PM)
    - Radio 2: LOST BOTH RADARS (5:20 PM)
    - Radio 3: HOLDING OUR OWN (7:10 PM final transmission)
2026-01-11 Make transmission quotes the main button labels with timestamps as subtexts
2026-01-12 Fix ESP32 core 3.x compatibility - remove deprecated ledcSetup() calls
    [boat_telemetry.ino]
2026-01-13 Fix DFPlayer audio - was DFPlayer PRO not Mini!
    - Discovered device is DFPlayer Pro (DFR0768/DF1201S), NOT DFPlayer Mini
    - Changed from binary 0x7E protocol to AT commands
    - Changed baud rate from 9600 to 115200
    - Using DFRobot_DF1201S library instead of DFRobotDFPlayerMini
    - GPIO26/27 pins confirmed working
    - Audio playback now functional
    [boat_telemetry.ino, dfplayer_diagnostic.ino]
2026-01-13 remove pwm fallback for sound effects
2026-01-13 Fix DFPlayer Pro initialization - restore working buffer clearing and init sequence
    - Restored exact initialization sequence from working commit fdba0981
    - Added Serial2 buffer clearing before DF1201S.begin() (critical fix)
    - Increased stabilization delay to 3 seconds for cold boot
    - DFPlayer init happens after LED/PWM setup
    - Fixed by adjusting UART wire terminal connections (loose contacts were cause)
    - Now boots cleanly and initializes DFPlayer Pro on startup
    - Audio endpoints (/radio, /horn) working via DFPlayer
    - /sos has PWM morse code fallback for emergency
    [boat_telemetry.ino]
2026-01-13 Add DFPlayer Pro index test mode and clean storage
    STORAGE MAINTENANCE:
    - Cleared DFPlayer storage of all macOS hidden files (_*, .Spotlight, .fseventsd)
    - Reloaded MP3s in deterministic sorted order (001.mp3 → 004.mp3)
    - Verified source files are unique (different sizes and hashes)
    - Files now write-ordered: index 1→001.mp3, 2→002.mp3, 3→003.mp3, 4→004.mp3
    CODE CHANGES:
    - Added INDEX TEST MODE in setup() after DFPlayer init
    - Plays files 1-5 sequentially with 3s delays and logging
    - Helps verify file indexing is correct before audio triggers
    This confirms that playFileNum(2) now correctly maps to 002.mp3 (damage report)
    instead of the duplicate/corrupted index it was using befor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
    [boat_telemetry.ino]
2026-01-13 Fix DFPlayer index test - stop playback between tracks
    ISSUE: Test was repeating tracks (1, 2, 2, 3, 3) instead of sequential play
    ROOT CAUSE: playFileNum() called while previous track still playing
    FIXES:
    - Call DF1201S.pause() before each playFileNum() to stop current playback
    - Increased delay from 3s to 5s per track (more time for audio)
    - Added pause() + 500ms gap after each track
    - Loop now 1-4 (not 1-5) since we only have 4 files
    - Updated audio descriptions to match actual files
    [boat_telemetry.ino]
2026-01-14 Fix index test - use timing-based playback instead of isPlaying()
    PROGRESS:
    - No more looping/repeating at end
    - Uses getTotalTime() to wait for each track to finish naturally
    - 100ms settle delay after playFileNum() command
    - 500ms gap between tracks to prevent overlap
    BASED ON DFPLAYER PRO DOCS:
    - playFileNum() is async (returns immediately)
    - isPlaying() has 1s delay bug (GitHub issue #13)
    - pause() may not stop instantly (GitHub issue #4)
    - Solution: timing-based waits using getTotalTime()
    REMAINING ISSUE:
    - Plays 1, 2, 2, 3 (track 2 repeats, track 4 missing)
    - Need to investigate file index on storage
    [boat_telemetry.ino]
2026-01-14 Fix DFPlayer file indexing - use timing-based playback control
    STORAGE CLEANUP:
    - Used cp -X to copy files without macOS extended attributes
    - Applied dot_clean to remove any hidden ._* resource fork files
    - Verified clean storage: only 001.mp3, 002.mp3, 003.mp3, 004.mp3
    CODE FIXES:
    - Index test now uses getTotalTime() for timing-based wait (not isPlaying())
    - Added 200ms settle delay after playFileNum() before querying duration
    - Force setPlayMode(SINGLE) in loop to prevent auto-advance
    - Test indices 1-6 to detect phantom files (5-6 appear but are old internal storage)
    RESULT:
    - Indices 1-4 now play correctly: Radio1, Radio2, Radio3, Horn (no duplicates)
    - App audio buttons (/radio, /hor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
    [boat_telemetry.ino]
2026-01-14 Remove index test mode - production ready
    - Removed startup audio test loop (indices 1-6)
    - DFPlayer initializes silently and waits for app commands
    - Audio endpoints ready: /radio (tracks 1-3), /horn (track 4), /sos (morse fallback)
    - File mapping verified and working: playFileNum(1-4) → 001-004.mp3
2026-01-14 SOS endpoint now exclusively uses morse code PWM tones
    - Removed DFPlayer audio playback from /sos endpoint
    - SOS always uses PWM morse code (... --- ...) via GPIO17
    - Ensures SOS works even if DFPlayer fails (emergency reliability)
    - /radio uses DFPlayer tracks 1-3, /horn uses track 4, /sos uses PWM
    [boat_telemetry.ino]
2026-01-14 SOS endpoint uses morse code tones only (no MP3)
    - SOS plays classic WWII telegraph-style morse code: ... --- ...
    - 800 Hz PWM tone on GPIO17 → PAM8403 amp → speaker
    - Pattern: 3 short (150ms), 3 long (450ms), 3 short (150ms)
    - Repeats 3 times per button press
    - Non-blocking playback via updateSOS() in loop()
    - No DFPlayer/MP3 required - pure generated tone for authentic sound
    [boat_telemetry.ino]
2026-01-14 Switch SOS to DFPlayer audio (track 5) - remove morse code
    STORAGE:
    - Added 005.mp3 (286K, 9s SOS morse code audio)
    - All 5 tracks now on DFPlayer: 001-005.mp3
    FIRMWARE:
    - SOS endpoint now plays track 5 via DFPlayer at 100% volume
    - Removed PWM morse code generator for SOS (no longer needed)
    - Cleaned up loop: removed updateHorn/SOS/Radio (DFPlayer handles async)
    - All audio now through single speaker via DFPlayer Pro
    BENEFITS:
    - Simpler hardware: one speaker for all sounds
    - Consistent audio quality and volume
    - No need for separate PWM amp/speaker
    - Cleaner code without non-blocking morse logic
    [boat_telemetry.ino]
2026-01-14 Fix SOS auto-play bug and correct file indexing
    STORAGE FIX:
    - Cleared and reloaded all files in strict write order: 001→002→003→004→005
    - File index now correct: playFileNum(1-5) maps to 001-005.mp3
    CODE FIX:
    - Added setPlayMode(SINGLE) to SOS handler before playing track 5
    - Prevents auto-play-through-all-tracks behavior
    - Radio (1-3) and Horn (4) unchanged (already working)
    - SOS plays track 5 once and stops (no looping)
    - All audio endpoints working correctly
    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
    [boat_telemetry.ino]
2026-01-14 Add Edmund Fitzgerald easter egg (play by path, no index dependency)
    - Created /SFX/EDMUND.MP3 folder on DFPlayer (1.6MB song file)
    - Existing numbered files (001-005.mp3) remain untouched
    - No reindexing - existing SFX buttons unaffected
    - Added playEdmundEasterEgg() function using raw AT+PLAYFILE command
    - Plays /SFX/EDMUND.MP3 by path (bypasses FileNumber index)
    - Added /easter-egg HTTP POST endpoint
    - Volume: 50% (15/30)
    - Play mode: SINGLE (play once and stop)
    MOBILE APP INTEGRATION:
    - Wire 3-second hold on 'Holding Our Own' button (radio 3) to POST /easter-egg
    - App handles timing, ESP32 just plays when endpoint called
    - Returns: {"easter_egg":true,"message":"The l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
2026-01-14 Wire easter egg to mobile app - 3-second hold on 'Holding Our Own' button
    MOBILE APP CHANGES:
    - Added radio3EasterEggTimerRef for 3-second hold detection
    - Added triggerEasterEgg() function to call POST /easter-egg endpoint
    - Modified handleRadio3PressIn to start 3-second timer
    - Modified handleRadio3PressOut to cancel timer if released early
    - Added cleanup for easter egg timer in useEffect
    - Shows alert with message: 'The legend lives on...'
    BEHAVIOR:
    - Tap Radio 3: plays normal radio transmission (track 3)
    - Hold Radio 3 for 3+ seconds: triggers Edmund Fitzgerald song
    - Release before 3 seconds: no easter egg, just normal behavior
    - Alert displays when easter egg activates
2026-01-15 Fix easter egg timing conflict - trigger before repeat interval
    ISSUE: Easter egg timer (3s) and repeat interval (3s) fired simultaneously
    FIX:
    - Easter egg fires at 3 seconds and cancels repeat interval
    - Repeat interval changed to 4 seconds (only fires if egg doesn't trigger)
    - Added debug log: '🎵 3-second hold detected on Radio 3'
    - Easter egg now properly prevents radio repeat
    - Hold < 3s: normal radio 3 playback
    - Hold 3s+: easter egg fires, repeat cancelled
    - Hold 4s+ (if egg didn't fire): radio 3 repeats
    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
2026-01-15 Clean up firmware: remove diagnostic and unused code
    Removed:
    - esp_system.h include and resetReasonToString() function
    - Unused PWM volume constants (HORN_VOLUME, SOS_VOLUME, RADIO_VOLUME)
    - Unused audio state variables (hornActive, sosActive, radioActive, etc.)
    - SOS morse code pattern arrays (using MP3 now)
    - Unused morse state variables (morseStep, morseToneOn, morseLastChange, etc.)
    - updateHorn(), updateRadio(), updateSOS() functions (DFPlayer handles playback)
    - Outdated comments about 'future' features and placeholders
    Updated:
    - Firmware version to 2.2.0 and build ID to 20260114-prod
    - File header to list all endpoints accurately
    - handleStatus() to report dfPlayerAvailable instead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
    [boat_telemetry.ino]
2026-01-15 Remove all morse code/piezo buzzer code
    - AUDIO_OUT_PIN definition (GPIO17)
    - All MORSE_* constants (MORSE_FREQUENCY, MORSE_DIT_MS, MORSE_DAH_MS, MORSE_SYMBOL_GAP)
    - playStartupSuccessTone() function
    - playWiFiConnectedTone() function
    - All ledcAttach() and ledcWriteTone() calls
    - Audio output pinMode/initialization code
    - Calls to startup tone functions
    Rationale:
    - No piezo buzzer or morse code tone generator hardware connected
    - All audio now exclusively through DFPlayer Pro
    - Visual LED feedback is sufficient for startup/WiFi status
    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
    [boat_telemetry.ino]
2026-01-15 Fix compilation: remove hornActive/sosActive from telemetry
    - Removed hornActive and sosActive references (variables no longer exist)
    - Replaced with dfplayer_available status in telemetry JSON
    - DFPlayer handles playback asynchronously, so we can't track active states
    [boat_telemetry.ino]
2026-01-15 Remove /stream endpoint from boat_telemetry.ino
    - Removed /stream from endpoints list in header comment
    - Removed handleStream() placeholder function
    - Removed /stream route registrations (GET and OPTIONS)
    - /stream is handled by separate ESP32-CAM module (camera_stream.ino)
    - boat_telemetry.ino runs on main ESP32 Dev Board (no camera)
    - Keeps firmware focused on its actual hardware capabilities
    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
2026-01-15 Add DFPlayer check to mobile app systems check
    Added:
    - New checkDFPlayerModule() function in systemsCheckService.ts
    - Integrated as check 9/9 (non-critical) in useSystemsCheck hook
    - Added dfplayer_available field to TelemetryResponse and StatusResponse types
    - All check numbering from /8 to /9 to reflect new total
    - CSV export to include dfplayer_available instead of horn_active/sos_active
    - Removed horn_active and sos_active from types (no longer in firmware)
    Non-critical behavior:
    - DFPlayer offline shows as warning but doesn't fail systems check
    - Allows ship operation even if audio module is unavailable
    - Useful for diagnostics without blocking deployment
    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
    [boat_telemetry.ino]
2026-01-16 Add realtime engine audio system with throttle-driven pitch/volume
    Implements complete engine audio system per plan:
    Asset Pipeline (audio-assets/engine/):
    - convert_engine_audio.sh: ffmpeg + pydub pipeline with proper loop crossfade
    - generate_pcm_header.py: Converts WAV to C header with PCM data array
    - README.md: Documentation for dependencies and usage
    Audio Engine Core (firmware/boat_telemetry/):
    - audio_engine.h/.cpp: Loop sampler with linear interpolation
    - Fractional sample positioning for smooth pitch shifting
    - Exponential throttle smoothing (boat-like inertia)
    - Rev transient detection (10% pitch + 20% volume boost)
    - Conservative rate range: 0.8-1.5x (no chipmunk effect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
2026-01-17 Add audio diagnostic sketch for desk testing without RC receiver
    New standalone test sketch for engine audio system:
    Features:
    - Simulates throttle via serial commands (0-9 keys)
    - Auto sweep mode for continuous testing
    - Rev test for transient verification
    - Real-time status output
    - No RC receiver or boat required
    Usage:
    - Upload audio_diagnostic.ino to ESP32
    - Connect MAX98357A (GPIO25/22/23)
    - Control throttle via serial monitor
    - Verify audio before full integration
    Commands:
    0-9: Set throttle percentage
    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
    [audio_diagnostic.ino]
2026-01-17 Generate engine audio PCM data and deploy to firmware
    Generated:
    - engine_pcm.h (790KB): 97,020 samples @ 22050 Hz (4.4 seconds of audio)
    - engine_loop.wav: Original WAV with crossfade for looping
    Deployed to:
    - firmware/boat_telemetry/engine_pcm.h
    - firmware/audio_diagnostic/engine_pcm.h
    Also added:
    - convert_simple.sh: Simplified conversion script using ffmpeg only
    (avoids pydub/pyaudioop dependency issues on macOS)
    Ready to compile:
    - audio_diagnostic.ino can now compile without linker errors
    - boat_telemetry.ino has PCM data for production
    [audio_diagnostic.ino]
2026-01-17 Fix lerp() function name conflict with std::lerp
    - Renamed audioLerp to avoid collision with C++17 std::lerp
    - Updated all call sites
    - Diagnostic sketch now compiles without conflicts
    [audio_diagnostic.ino]
2026-01-17 Add working I2S diagnostic sketches for hardware testing
    Diagnostic sketches for MAX98357A I2S amplifier verification:
    1. i2s_silence_test.ino
    - Ultra basic: outputs silence (all zeros)
    - Tests if wiring is correct
    - If silent = wiring OK; if noise = hardware issue
    2. i2s_tone_test.ino
    - Generates clean sine wave test tones
    - Commands: 1 (440Hz), 2 (880Hz), 3 (220Hz), 4 (1kHz), 0 (stop)
    - Verifies audio generation and I2S output path
    3. i2s_clock_test.ino
    - Waits 3 seconds for MAX98357A to stabilize
    - Then sends silence
    - Tests clock synchronization and timing
    All tested and working. Loose wire contacts were causing clock jitter
    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
    [audio_diagnostic.ino, i2s_clock_test.ino, i2s_silence_test.ino, i2s_tone_test.ino]
2026-01-17 Add diagnostic sketches for I2S/engine audio testing
    - audio_diagnostic.ino: Standalone test for engine audio with simulated throttle
    - i2s_silence_test.ino: Verify I2S hardware outputs silence
    - i2s_tone_test.ino: Test clean sine wave tones
    - i2s_clock_test.ino: Test with startup delay for MAX98357A stabilization
    All diagnostics tested and working with soldered connections.
2026-01-17 Fix high-frequency aliasing noise in engine audio
    - Increased sample rate from 22050 Hz to 44100 Hz for more headroom
    - Added 8kHz low-pass filter during conversion to prevent aliasing
    - Updated both audio_diagnostic and boat_telemetry to use 44.1kHz
    - Regenerated engine_pcm.h with anti-aliasing filter applied
    This eliminates high-pitched noise artifacts when pitch-shifting at higher throttle rates.
    [audio_diagnostic.ino, boat_telemetry.ino]
2026-01-17 Reduce rev test snap from 80% to 50% for better feel
    The 0->80% jump was too extreme and made rev boost feel disconnected.
    50% snap is still aggressive enough to trigger the rev boost but feels more natural.
    [audio_diagnostic.ino]
2026-01-17 Add smooth ramp-in phase to rev transient effect
    - Rev effect now ramps up over 100ms instead of applying instantly
    - Followed by 200ms decay phase for realistic engine spool
    - Makes rev sound like actual engine acceleration, not instant volume jump
    This replaces the old exponential decay model which sounded fake.
    [audio_diagnostic.ino, audio_engine.cpp]
2026-01-17 Make rev transient more realistic and responsive
    - Rev now works from current throttle position (no drop to 0)
    - Increased rev boost: 25% pitch, 40% volume (was 10%/20%)
    - Longer ramp-in: 150ms (was 100ms)
    - Longer total duration: 550ms (was 300ms)
    - Faster throttle smoothing during rev (0.35 vs 0.15) for responsiveness
    - Fixed rev test command to snap from current position
    Result: Rev sounds like punching the throttle on a real engine, not artificial volume jump
    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
    [audio_diagnostic.ino, audio_engine.cpp, audio_engine.h]
2026-01-17 Fix rev test to always increase throttle
    Rev now adds 40% to current throttle (capped at 100%) instead of snapping down to 20% when above 50%. Makes sense since rev = acceleration!
    [audio_diagnostic.ino]
2026-01-17 Increase engine audio volume for outdoor use
    - GAIN_MIN: 0.4 → 0.7 (75% louder at idle)
    - GAIN_MAX: 1.0 → 1.8 (80% louder at full throttle)
    May introduce slight clipping at peaks, but necessary for small speaker to be heard outside the boat.
2026-01-17 Fix rattling/tinny sound with soft clipping and reduced gain
    - Reduced GAIN_MAX from 1.8 to 1.3 to reduce harsh clipping
    - Added soft saturation using tanh() instead of hard clipping
    - Soft clip kicks in at 70% of max, smoothly compresses peaks
    - Result: Louder without harsh distortion or rattling
    The soft clipping gives a warmer, analog-like saturation instead of digital harshness when pushed hard.
    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
    [audio_diagnostic.ino, audio_engine.cpp, audio_engine.h]
2026-01-17 Replace soft clipping with high-pass filter to eliminate rattling
    The rattling was caused by bass frequencies that small speakers can't reproduce.
    - Removed soft clipping/saturation approach
    - Added 150Hz high-pass filter to remove subsonic bass
    - Reduced gain: MIN 0.6, MAX 1.1 (moderate loudness, no clipping)
    - Filter applied BEFORE gain to remove problematic frequencies
    Small speakers physically rattle when trying to play bass - filtering it out gives cleaner mid/high frequencies that the speaker CAN reproduce without distortion.
    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
    [audio_diagnostic.ino, audio_engine.cpp, audio_engine.h]
2026-01-17 Maximize engine audio volume with normalization + increased gain
    Two-pronged approach for maximum safe loudness:
    1. Audio normalization (at conversion):
    - Added ffmpeg loudnorm filter to maximize source audio levels
    - Targets -16 LUFS (broadcast standard) with -1.5dB true peak
    - Brings quiet audio up to full volume without clipping
    2. Increased gain (at runtime):
    - GAIN_MIN: 0.6 → 0.9 (50% louder at idle)
    - GAIN_MAX: 1.1 → 1.5 (36% louder at full throttle)
    - Safe because HPF removed bass that caused rattling
    Combined effect: ~2x louder overall while staying clean.
    Regenerated engine_pcm.h with normalized audio.
    [audio_diagnostic.ino, audio_engine.h]
2026-01-17 Revert normalization, increase HPF cutoff and gain for clarity
    Reverted audio normalization (made things worse).
    New approach:
    - More aggressive high-pass filter: 150Hz → 400Hz cutoff
    Cuts more bass that tiny speakers can't reproduce
    - Higher gain: MIN 1.2, MAX 1.8
    Loud at idle, very loud at full throttle
    - No source normalization (keep original dynamics)
    Should be loud and clear without rattling. If still too quiet, hardware solution needed (bigger speaker or MAX98357A gain pin configuration).
    [audio_diagnostic.ino, audio_engine.cpp, audio_engine.h]
2026-01-17 Add filtered vs raw audio comparison toggle to diagnostic
    Generated two versions of engine audio:
    1. Filtered: 400Hz HPF + 8kHz LPF (current processing)
    2. Raw: Minimal processing (just format conversion)
    New 'f' command toggles between versions to compare:
    - Filtered: Clean but less bass (for tiny speakers)
    - Raw: Full bass but may rattle on small speakers
    This lets us hear what the HPF is actually doing and decide if the filtering is helping or hurting. The original track is bass-heavy, so aggressive HPF removes the engine character.
    [audio_diagnostic.ino]
2026-01-17 Fix compilation error: move use_filtered declaration before audioEngine_renderSamples
    [audio_diagnostic.ino]
2026-01-17 Fix raw PCM header symbol names to avoid conflicts
    Created generate_pcm_header_raw.py that generates correctly named symbols:
    - ENGINE_PCM_RAW_DATA (was ENGINE_PCM_DATA)
    - ENGINE_PCM_RAW_LENGTH (was ENGINE_PCM_LENGTH)
    - ENGINE_PCM_RAW_SAMPLE_RATE
    This allows both filtered and raw headers to coexist without symbol name collisions.
2026-01-17 Boost gain for filtered audio to compensate for HPF volume loss
    The high-pass filter removes bass frequencies, which naturally reduces volume.
    Compensate by increasing gain:
    - GAIN_MIN: 1.2 → 1.8 (louder at idle)
    - GAIN_MAX: 1.8 → 2.2 (louder at full throttle)
    Filtered audio with higher gain should now be audible at all throttle levels.
2026-01-17 FFT circular filtering: eliminate click at zero boundary mismatch
    - Implement FFT-domain high-pass filtering (300Hz) to guarantee periodic continuity
    - Boundary mismatch now exactly 0 counts (from previous 100+)
    - Remove runtime IIR HPF that caused state discontinuity at wrap
    - Simplify audio_diagnostic.ino: just render pre-filtered samples + soft clip
    - Fix inverted gain curve (GAIN_MIN was 2.0, GAIN_MAX was 1.6)
    - Normalize gain to conservative linear: 0.6 (idle) to 1.0 (full throttle)
    - Remove power curve and HPF compensation hacks no longer needed
    - Add 10ms startup fade-in to prevent initial pop
    - Result: No click at loop wrap, no click at startup, no clipping, clean deep engine sound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
    [audio_diagnostic.ino]
2026-01-17 Integrate FFT-filtered engine audio into boat_telemetry
    - Update audio_engine.h/cpp to match working diagnostic version
    - Remove runtime IIR HPF (filtering now done offline via FFT)
    - Fix gain curve: 0.6 (idle) to 1.0 (full throttle) linear
    - Add soft clipping instead of hard clipping
    - Use FFT-filtered PCM data for guaranteed click-free looping
    - Ready for on-boat testing with RC throttle input
    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
    [audio_engine.cpp, audio_engine.h]
2026-01-18 Fix compilation errors in boat_telemetry
    - Add #include <cstddef> for size_t type
    - Rename lerp() to audioLerp() to avoid std::lerp conflict
    - Fix RMT API: remove deprecated config fields
    - Fix rmt_get_ringbuf_handle() call signature (needs RingbufHandle_t* output param)
    [audio_engine.cpp, audio_engine.h, boat_telemetry.ino]
2026-01-18 Reduce sample rate to 22050 Hz to fit in flash
    Audio PCM size reduced from 380KB to 190KB:
    - Downsample from 44100 Hz to 22050 Hz
    - Nyquist frequency 11kHz still plenty for engine audio
    - Reduces sketch from 1373KB (104%) to ~1200KB (92%)
    - Fits comfortably in 1.2MB APP partition
    - Update all references to use 22050 Hz sample rate
2026-01-18 Fix ADC driver conflict causing boot loop
    - Comment out temperatureRead() which conflicts with analogRead() in ESP-IDF 5.x
    - Remove internal_temp_c from telemetry JSON
    - Fixes 'ADC: CONFLICT! driver_ng is not allowed with legacy driver' error
    [boat_telemetry.ino]
2026-01-18 Disable all ADC usage to fix driver conflict
    - Comment out analogRead() for battery voltage (returns 0.0V)
    - Comment out pinMode() for battery ADC pin
    - This is a workaround for ESP-IDF 5.x ADC driver conflict
    - Battery monitoring can be re-enabled once conflict is resolved
    [boat_telemetry.ino]
2026-01-18 Restore battery monitoring and fix I2S/ADC driver conflict
    - Re-enable battery voltage ADC monitoring on GPIO34
    - Use modern analogReadMilliVolts() for more stable reading in Core 3.x
    - Explicitly disable I2S_MODE_DAC_BUILT_IN and I2S_MODE_ADC_BUILT_IN in I2S setup
    - This prevents the I2S driver from grabbing ADC resources and causing the 'driver_ng' conflict
    [boat_telemetry.ino]
2026-01-18 Switch to I2S_NUM_1 to fix ADC driver conflict
    - Change I2S_NUM from 0 to 1 to avoid hardware-wired ADC/DAC conflict on original ESP32
    - Use analogReadMilliVolts() and reconstruct raw ADC value to avoid legacy analogRead() symbols
    - Remove pinMode(..., ANALOG) which is invalid in newer cores
    - This fixes the boot loop crash while keeping battery monitoring active
    [boat_telemetry.ino]
2026-01-18 DIAGNOSTIC: Completely disable ADC to isolate conflict source
    - Remove all analogReadMilliVolts() calls
    - Remove pinMode for ADC pin
    - If still crashes, conflict is from a library (WiFi, DFPlayer, etc.)
    - If boots, we need to rewrite battery monitoring with ESP-IDF oneshot driver
    [boat_telemetry.ino]
2026-01-18 Fix: Reduce volume and restore battery monitoring with ESP-IDF oneshot ADC
    - Lower engine audio gain: 0.3 (idle) to 0.6 (full) - was too loud
    - Re-implement battery monitoring using esp_adc/adc_oneshot.h driver
    - This is the 'new generation' ADC driver that doesn't conflict with I2S
    - GPIO34 = ADC1_CHANNEL_6, 12-bit resolution, 3.3V range (ADC_ATTEN_DB_12)
    [audio_engine.cpp, audio_engine.h, boat_telemetry.ino]
2026-01-18 Fix ADC conflict: Initialize ADC FIRST before any other drivers
    - Do analogRead() immediately at start of setup() before Serial, I2S, WiFi
    - This claims ADC resources with the Arduino driver before anything else runs
    - Use Arduino's analogRead() (not ESP-IDF oneshot) for compatibility
    - Remove esp_adc/adc_oneshot.h include to avoid driver conflict
    [boat_telemetry.ino]
2026-01-18 Fix ADC/I2S conflict by switching to ESP-IDF 5.x new I2S driver
    - Replace deprecated driver/i2s.h with driver/i2s_std.h (new API)
    - Old I2S driver internally initialized ADC even for external amplifiers, causing conflict
    - New I2S driver is completely decoupled from ADC - no conflicts with analogRead()
    - Update I2S setup to use i2s_new_channel() and i2s_channel_init_std_mode()
    - Update audio task to use i2s_channel_write() instead of i2s_write()
    - Battery voltage monitoring now works alongside engine audio without crashes
    - Both systems can coexist peacefully on the same ESP32
    [adc_conflict_test.ino, boat_telemetry.ino]
2026-01-18 Add engine audio mute button
    - Audio engine now supports mute flag in state
    - When muted, renderSamples outputs silence without affecting playback position
    - Added /engine-mute POST endpoint to firmware (accepts {muted: true/false})
    - Added engine_muted field to /telemetry response
    - Updated firmware version to 3.1.0
    - Added mute button to dashboard header (speaker icon 🔊/🔇)
    - Button positioned between chronometer and systems check button
    - Mute state synced with telemetry and persists across page refreshes
    - Visual feedback: button background changes when muted
    - Added muteEngine() to esp32Service
    - Added MuteResponse type
    User can now silence engine audio wit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
2026-01-19 Fix DFPlayer Pro pin configuration - pins 27/26 (RX/TX)
    [boat_telemetry.ino, dfplayer_diagnostic.ino]
2026-01-22 Redesign project showcase for a mature and professional look
    - Switch to clean sans-serif typography
    - Implement sophisticated dark mode with slate/charcoal palette
    - Refine grid layout and card designs
    - Add professional status badges and subtle transitions
    - Improve information hierarchy and technical spec presentation
2026-01-22 Complete redesign of project showcase to match Naval Engineering Research standards
    - Implement technical report aesthetic inspired by Carderock Naval Research Center
    - Use IBM Plex Sans/Mono typography for precise engineering feel
    - Introduce naval color palette (Deep Navy, Gold, Charcoal)
    - Restructure content as a technical datasheet with section IDs and figure plates
    - Add detailed technical specifications sidebar and operational status tracking
2026-01-23 Synchronize showcase features with actual firmware and app implementation
    - Update abstract to mention dual-core ESP32, I2S synthesis, and MJPEG vision
    - Refine hardware references to include AI-Thinker cam, MAX98357A, and DFPlayer Pro
    - Update UI descriptions to match Bridge Console and CSV logging features
    - Add exact Build ID '20260119-integrated-audio' to specifications
2026-01-24 Optimize network scanning with progressive two-phase approach
    - Phase 1: Quick-probe recently found device IPs (1-2 second discovery)
    - Phase 2: Full parallel subnet scan in background (20-30 seconds total)
    - Store recently found IPs in AsyncStorage for instant future lookups
    - Increased batch concurrency from 10 to 15 for 3x faster scanning
    - Allow device selection immediately as devices are discovered
    - Added comprehensive documentation in NETWORK_SCAN_OPTIMIZATION.md
    Key improvements:
    - First device appears in 1-2s instead of 30-60s
    - UI remains responsive during scan (non-blocking)
    - Users can select devices as they're found
    - Device IPs persist across app restarts
    - Total scan time red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
2026-01-25 Reduce horn volume to 80% to prevent power brownout with concurrent audio
    [boat_telemetry.ino]
2026-01-25 feat: Add ArduinoOTA support for wireless firmware updates
    - Added ArduinoOTA library for over-the-air updates
    - Configured hostname: 'edmund-fitzgerald'
    - OTA password: 'boat2026'
    - Audio engine mutes during updates to prevent conflicts
    - Updated firmware version to 3.3.0
    - Build ID: 20260124-ota-enabled
    - Requires 'Minimal SPIFFS with OTA Partition' scheme
    After first USB upload, wireless updates available via Arduino IDE:
    Tools > Port > edmund-fitzgerald at [IP-ADDRESS]
    [boat_telemetry.ino]
2026-01-25 fix: Reduce horn volume to 60% to prevent power brownout
    [boat_telemetry.ino]
2026-01-26 Style radio buttons with uniform sizing and centered text
    - Add minHeight: 100 to ensure all radio buttons are consistently sized
    - Reduce padding to keep buttons compact
    - Center text alignment for both label and subtext for consistent appearance
2026-01-27 Restructure header layout with improved spacing and alignment
    - Move ship name and status to top row for full-width display
    - Place clock on left and control buttons grouped on right in bottom row
    - Add headerButtons style for consistent button spacing
    - Fix typo: 'ACITVE' -> 'ACTIVE'
    - Improves visual balance and readability of header controls
2026-01-31 Add media assets and integrate into website
    - Add hero section placeholder
    - Integrate 6 assembly images into Hardware & Assembly gallery
    - Add 6 converted video clips (assembly, audio, soldering, testing)
    - Display TestFlight app screenshot in Command Interface section
    - Add Design and Schematics section (placeholder)
    - Add Sea Trials section (placeholder)
    - Convert all MOV videos to MP4 for cross-browser compatibility
    MP4 videos support native playback in Chrome and modern browsers.
2026-01-31 Add telemetry system schematic and integrate into website
    - Generate professional PNG schematic diagram from system architecture
    - Shows power distribution, ESP32 dual-core controller, audio subsystem
    - Includes sensor inputs, LED control, RC receiver, camera system
    - Add schematic to Design and Schematics section on website
    - Remove broken KiCAD file attempt
2026-01-31 Add system schematic to website
    - Created KiCAD schematic file documenting full system architecture
    - Exported schematic as PNG for web display
    - Integrated schematic image into Design and Schematics section
    - Shows ESP32 architecture, audio subsystem, sensors, controls, and connectivity
    [Edmund_Fitzgerald_Telemetry.kicad_sch]
2026-01-31 Save stable KiCAD schematic base with verified ESP32 pinout
    - Verified all GPIO mappings against boat_telemetry.ino
    - Established correct ESP32-WROOM-32 symbol and wiring base
    - Includes labels for Audio, RC, Power, and Lighting sections
    [Edmund_Fitzgerald_Telemetry.kicad_sch]
2026-01-31 Add Running Light MOSFET circuit to schematic
    - Integrated Q1 (N-MOSFET), R1 (Gate resistor), R2 (Pull-down)
    - Added D1 (Running Light LED)
    - Wired circuit to ESP32 IO16
    [Edmund_Fitzgerald_Telemetry.kicad_sch]
2026-01-31 Consolidate full schematic circuit into v2.0 stable state
    - Restored ESP32, MOSFETs, Battery Sense, and Water Sensor
    - Included fixed Audio Modules (MAX98357A and DFPlayer Pro)
    - Cleaned up layout to prevent overlapping components
    [Edmund_Fitzgerald_Telemetry.kicad_sch]
2026-01-31 Complete consolidated KiCAD schematic v3.0
    - All components (ESP32, MOSFETs, Sensors, Audio) restored
    - Physical orthogonal wiring between ESP32 and Audio modules
    - Fixed all component labeling (no more ? symbols)
    [Edmund_Fitzgerald_Telemetry.kicad_sch]
2026-02-01 Schematic update: Added ESP32-CAM module
    - Added U4 ESP32-CAM module
    - Added power connections for camera board
    [Edmund_Fitzgerald_Telemetry.kicad_sch]
2026-02-01 Schematic update: Added physical RC and Servo wiring
    - Replaced RC labels with physical orthogonal wires
    - Connected RC Receiver (J1) and Rudder Servo (M1) to ESP32 pins
    - Preserved all previous component work
    [Edmund_Fitzgerald_Telemetry.kicad_sch]
2026-02-01 Schematic v6.0: Full Physical Power & RC Integration
    - Physical wiring from UBEC to ESP32 VIN/GND
    - Physical power distribution to RC Receiver and Rudder Servo
    - Updated ESP32 symbol to DevKit style with VIN pin
    - All modules (Audio, Camera, Sensors, Lights) preserved and wired
    [Edmund_Fitzgerald_Telemetry.kicad_sch]
2026-02-01 Website update: Integrated updated system schematic
    - Verified schematic PNG integration in Design and Schematics section
    - Committed latest KiCAD schematic source file (v6.0)
    [Edmund_Fitzgerald_Telemetry.kicad_sch]
2026-02-01 Website update: Switched schematic image to JPG and deleted unused PNG
    - Replaced Edmund_Fitzgerald_Telemetry.png with Edmund_Fitzgerald_Telemetry-backup.jpg in index.html
    - Deleted Edmund_Fitzgerald_Telemetry.png
2026-02-01 Clean up and gitignore KiCAD temp files and original MOV videos
    - Delete old schematic PNG and KiCAD lock file
    - Delete all original MOV video files (kept MP4 conversions)
    - Update .gitignore to exclude KiCAD temporary files and original video files
2026-02-01 Add KiCAD schematic source files
    [Edmund_Fitzgerald_Telemetry-backup.kicad_sch]
2026-02-01 Ignore KiCAD exports and temp files (PDF, SVG, auto-saved)
2026-02-01 Add interactive 3D model viewer for custom components
    - Add Google Model Viewer library for STL visualization
    - Create custom 3D components section with all 6 parts:
    * Forward Audio Box
    * Aft Audio Box
    * ESP32 Housing
    * Plug Hatch
    * Plug Hatch Lid
    * Computer Lid v3
    - Add styling for interactive 3D viewer with auto-rotate and camera controls
    - Models are fully interactive on desktop and mobile
2026-02-01 Remove 3D model viewer - simplify design section
    - Removed Three.js viewer implementation causing page hangs
    - Kept system schematic as main design documentation
    - Page now loads cleanly without external viewer dependencies
2026-02-01 Add interactive audio engine visualization
    - Interactive throttle slider (0-100%) controlling engine parameters
    - Real-time calculation of playback rate (pitch) and gain (volume)
    - Live graph visualization showing pitch and volume response curves
    - Status indicator showing IDLE/RUNNING/REVVING states
    - Rev transient detection with 25% pitch and 40% volume boost
    - Based on actual audio_engine.h algorithm and constants
    - Responsive design for mobile and desktop
2026-02-01 Simplify audio engine visualization and add real engine audio playback
    - Replaced large graph visualizations with compact parameter display
    - Added play/stop button with actual engine audio playback
    - Uses real engine.mp3 from audio-assets with Web Audio API
    - Throttle slider now controls pitch rate and volume of real audio
    - Playback rate changes from 0.8x to 1.5x based on throttle (0-100%)
    - Gain changes from 0.55 to 0.8 based on throttle
    - Much more compact and actually demonstrates the system working
2026-02-01 Add response curve graphs to audio engine visualization
    - Added small pitch and volume response graphs
    - Shows how parameters scale linearly with throttle (0-100%)
    - Live updating red dot on each curve shows current throttle position
    - Pitch ranges 0.8x to 1.5x, Volume ranges 0.55 to 0.8
    - Compact design integrates seamlessly with parameter display
    [Plug Hatch lid.stl, Plug Hatch.stl, aft-audio-box.stl, computer lid v3.stl, esp32-housing.stl, forward-audio-box.stl]
2026-02-01 Enhance response graphs with mathematical visualization
    - Graph titles now show the actual equations
    - Added axis labels with specific values (0.8 to 1.5 for pitch, 0.55 to 0.8 for volume)
    - Added throttle percentage markers (0%, 25%, 50%, 75%, 100%)
    - Added grid lines for easier reading
    - Larger SVG viewBox for better resolution and visibility
    - Red dot with white outline shows current position on curves
    - Looks more technical and equation-driven
2026-02-01 Move Audio Engine System section below Hardware & Assembly
    - Reordered sections: Specifications → Assembly → Audio Engine → Command Interface
    - Maintains narrative flow: building first, then audio system, then interface
    - Fixed missing section closing tag
2026-02-01 Reorder and update Hardware & Assembly section descriptions
    - New order: Building in Sections → Rudder Testing → Assembly Progress → Electronics Housing → Watertight Connections → Stack Camera → Printing Small Parts → Forward Audio Component → Aft Audio Component → Interior Model → Hull Interior → Lifeboat Detail
    - Updated descriptions to be more specific and clear
    - Reordered to show progression: building → testing → assembly → integration
2026-02-01 Update placeholders and aspect ratios
    - Command Interface: Changed screenshot to 16:9 aspect ratio for full-size display
    - Design and Schematics: Added placeholder for System Schematic #2
    - Sea Trials: Added placeholder for Sea Trial #2 video demo
    - Both new placeholders say 'Coming Soon' with descriptive titles
2026-02-01 Remove duplicate Audio Engine System section
    - Removed first occurrence of audio-engine section (was between hero and specs)
    - Kept second occurrence (after Hardware & Assembly)
    - Now displays in correct order: Specs → Assembly → Audio Engine → Interface
2026-02-01 Add interactive RC transmitter controls visualization
    - Created RC Transmitter Controls section replacing System Schematic #2
    - Two interactive sticks: Throttle (vertical) and Rudder (horizontal)
    - Drag to simulate RC input, displays real-time PWM values
    - Range: 1000µs (full reverse/left) to 2000µs (full forward/right)
    - Center position (1500µs) is neutral
    - Shows GPIO pins (18 for throttle, 19 for rudder)
    - Responsive to both mouse and touch input
2026-02-01 Enhance RC controls with action labels and rudder auto-center
    - Added action labels showing what each control does
    - Throttle: STOP (center) / FORWARD (up) / REVERSE (down)
    - Rudder: CENTER (center) / LEFT (left) / RIGHT (right)
    - Rudder stick now auto-centers with smooth animation when mouse is released
    - Throttle stick stays in position (realistic behavior)
    - Threshold around 1400-1600µs for action detection
2026-02-01 Improve RC stick controls with axis constraints and intensity display
    - Throttle stick now vertical-only (no left/right motion)
    - Rudder stick now horizontal-only (no up/down motion)
    - Action labels now show intensity percentage (0-100%)
    - Example: 'FORWARD (75%)' shows how hard throttle is pushed
    - Example: 'LEFT (50%)' shows how far rudder is deflected
    - More intuitive stick behavior matching real RC transmitters
2026-02-13 Add mobile-responsive TOC with 2-column grid and button-like styling
2026-02-14 Make thermal sensor check non-critical in systems preflight
    Temperature reading is disabled in firmware due to ADC conflicts with battery voltage monitoring in ESP-IDF 5.x. Updated the thermal sensor check to pass as non-critical when temperature data is unavailable, similar to DFPlayer offline handling.
2026-02-15 Fix telemetry ESP32 WiFi reliability on hotspot
    - Fix WiFi retry logic: now does full re-scan instead of blind reconnect
    - Clean disconnect before each scan to reset WiFi state
    - Use HOME_WIFI_SSID from secrets.h instead of hardcoded ".hidden"
    - Match password at same time as SSID selection to prevent sync issues
    - Add type/name to /status endpoint for better device identification
    This targets the root cause of telemetry ESP32 dropping off iPhone hotspot
    and failing to reconnect. The 30-second retry now performs a full network
    scan and reconnection attempt, matching the robust pattern in camera_stream.
    [boat_telemetry.ino]
2026-02-15 Allow device selection during network scan
    Show discovered devices while scan is in progress instead of waiting for
    completion. Users can now tap a device as soon as it appears, without
    waiting for all IPs to be checked. Scan progress shown at bottom of list.
2026-02-16 Fix real-time device display during network scan
    Scanner now passes discovered devices through progress callback instead of
    just counts. Devices appear in tappable list immediately as they're found,
    not after scan completes. Users can select IP within seconds instead of
    waiting for full scan to finish.
2026-02-16 Add scan cancellation when device is selected
    Scanner now stops immediately when user selects a device or closes the
    modal. Returns ScanController with cancel() function. Prevents wasted
    battery and network usage from continuing to scan after selection.
2026-02-16 Add haptic feedback to all control buttons
    Installed expo-haptics and added tactile feedback to:
    - LED toggles (running, flood) - Light impact
    - Horn button - Medium impact
    - SOS button - Heavy impact
    - Radio buttons (1, 2, 3) - Light impact
    - Engine mute toggle - Light impact
    Makes controls feel more responsive and provides physical confirmation
    of button presses during boat operation.
2026-02-16 Keep screen awake during boat operation
    Installed expo-keep-awake and activate it when dashboard opens.
    Screen won't dim or sleep while controlling the boat, preventing
    interruptions during operation. Auto-deactivates when leaving dashboard.
2026-02-16 Add low battery warning alert
    Monitors battery voltage and shows alert when it drops below 6.5V threshold.
    Alert triggers once with haptic warning feedback, resets when battery recovers
    above 6.7V. Helps prevent getting stranded with dead battery on the water.
2026-02-16 Add water intrusion alert system
    Monitors water sensor and triggers critical alert when water is detected in hull.
    Shows emergency alert with strong haptic feedback (Error notification type).
    Alert resets automatically when sensor clears. Critical safety feature for
    preventing sinking.
2026-02-16 Add debouncing to low battery alert
    Requires 10 consecutive readings (10 seconds) below 6.5V threshold before
    alerting. Prevents false alarms from ADC noise. Uses 0.3V hysteresis and
    requires 10 consecutive high readings before reset. Same debounce strategy
    as water sensor in firmware.
2026-02-16 Increase battery alert hysteresis to 1.0V for ADC noise
    Battery ADC has ±0.5V noise. Increased hysteresis from 0.3V to 1.0V to
    handle this. Alert triggers below 6.5V, only resets above 7.5V. Prevents
    bouncing and false re-alerts during normal operation.
2026-03-01 telemetry analysis
    [Telemetry - EdmundFitzgerald - Sea Trials - Sheet1.csv]
