ryanmio/EdmundFitzgeraldController/docs/images/assmembling-computer.jpeg

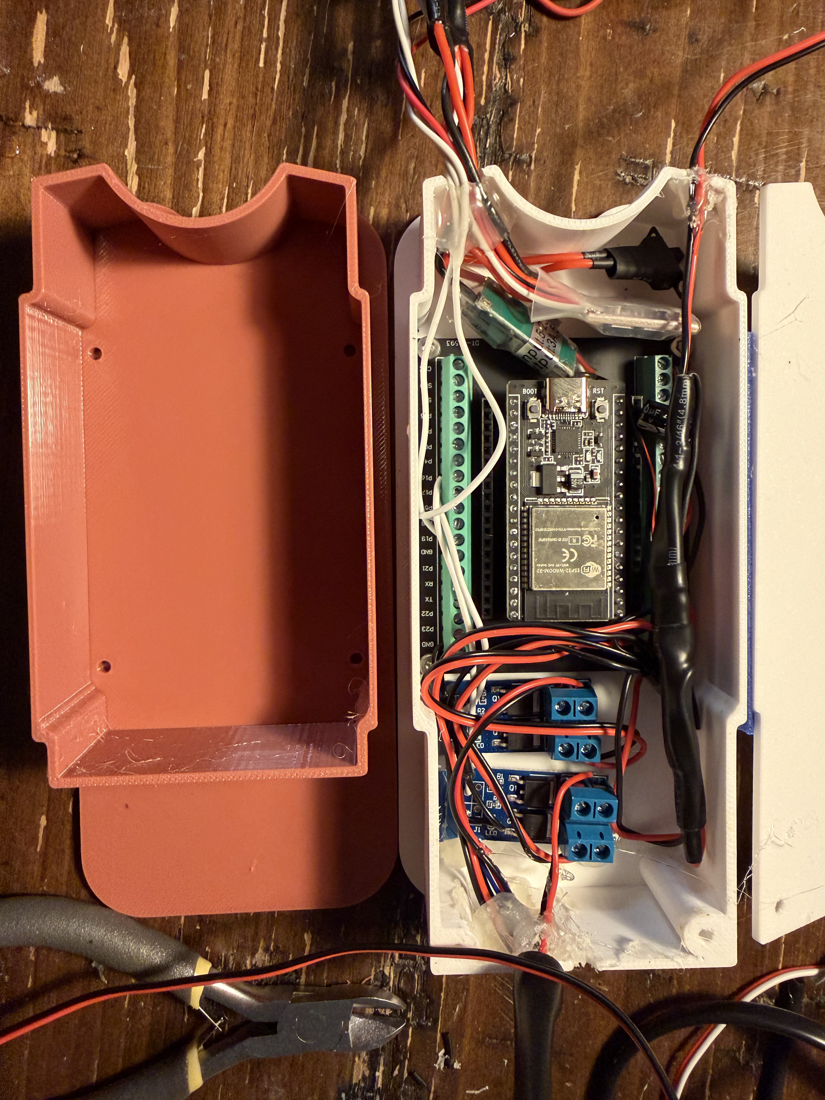
docs/images/assmembling-computer.jpeg
