ryanmio/EdmundFitzgeraldController/docs/images/printing-small-parts.jpeg

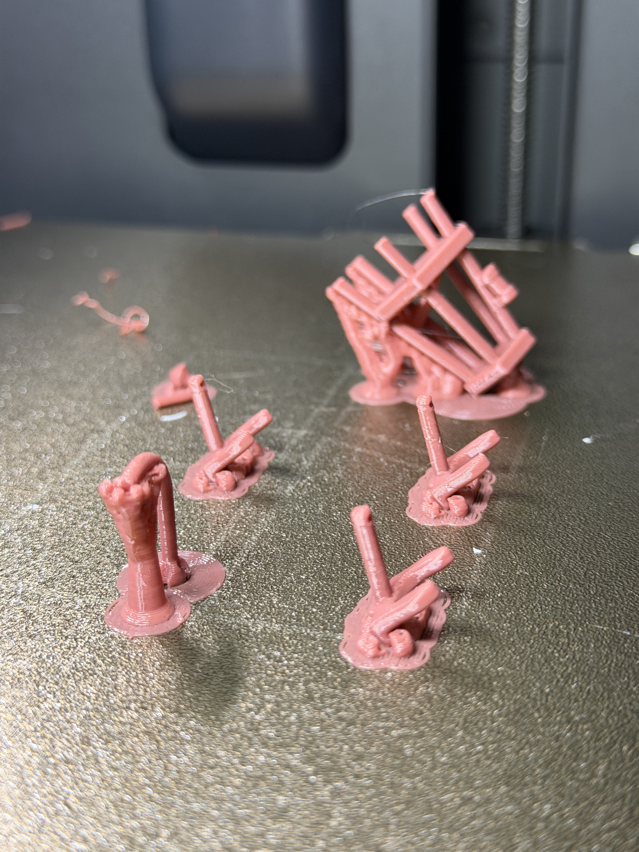
docs/images/printing-small-parts.jpeg
