ryanmio/EdmundFitzgeraldController/docs/images/building-in-sections.jpeg

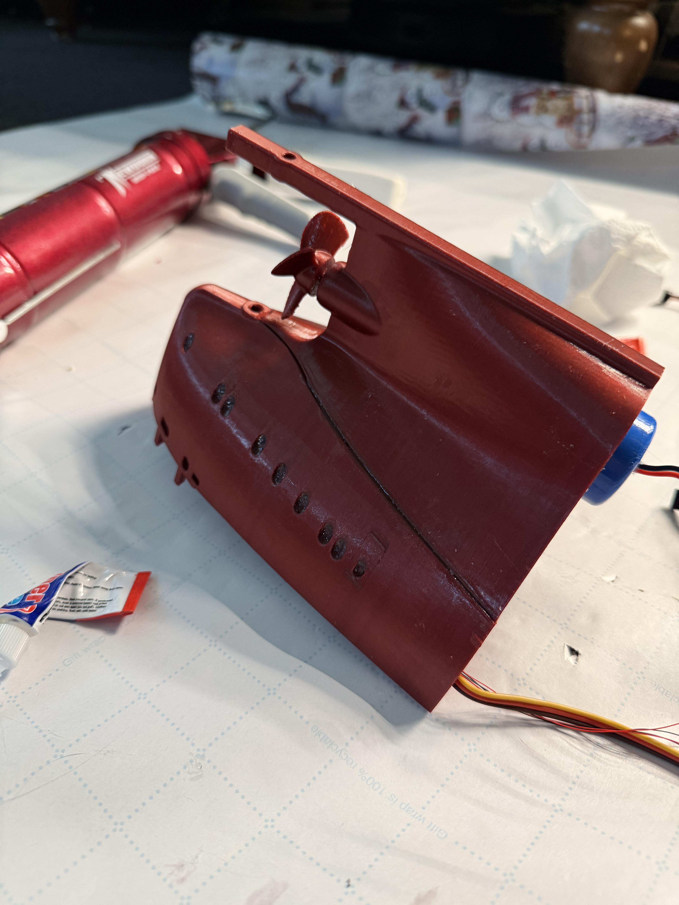
docs/images/building-in-sections.jpeg
